danielbrownjr/JumpJet/docs/PHASE1_HARDWARE_REGISTER.md

# Phase 1 hardware source-of-truth register

Last updated: 2026-09-15

This is the living engineering register for JumpJet Rev A Phase-1 hardware
implementation. It records what is known, how it is known, what remains
provisional, and which downstream decisions are blocked. Rev A.4.1 is the
current authoritative schematic baseline and its KiCad source is checked into
the repository; the first Rev A PCB remains active Phase-1 implementation work.

> **Presence in this register does not mean BOM-final, fabrication-approved, or
> release-approved. Only the explicit status field carries authority.**

## Status legend

| Status | Meaning |
|---|---|
| CONFIRMED FACT | Supported by an authoritative project artifact or direct evidence; not merely inferred. |
| MEASURED | Directly measured, with the measurement conditions and source identified. |
| DESIGN DECISION | Deliberately selected architecture or requirement; implementation may still need validation. |
| STRONG CANDIDATE | Preferred component candidate with substantial support, but not BOM-final. |
| PROTOTYPE CANDIDATE | Part selected for characterization or prototyping only. |
| ASSUMPTION / PROVISIONAL | Working value or approach that must not be treated as final. |
| TBD / BLOCKED | Required information or selection is absent and blocks one or more downstream activities. |

Confidence describes the quality of the current evidence, not release readiness.
The **Blocks** column identifies what cannot be frozen or completed until the
remaining validation closes.

## 1. System electrical basis

| Item | Status | Current value / decision | Evidence / source | Confidence | Remaining validation | Blocks |
|---|---|---|---|---|---|---|
| System voltage | CONFIRMED FACT | 24 V system architecture. | Rev A.4.1 schematic; [CZ4060 characterization](hardware/cz4060-characterization.md) | High | Validate production-supply tolerance and transients with the complete assembly. | BOM freeze + Fabrication |
| CZ4060 conservative design basis | CONFIRMED FACT | Size the heater path for 24 V, 200 W, and 8.33 A. | Heater rating and [CZ4060 characterization](hardware/cz4060-characterization.md), commit `903e5e0cdfc7a17102d51de1c01fa414be613b92` | High | Validate every production current-path element at this design load and installed temperature. | PCB layout + BOM freeze + Fabrication |
| Standalone sustained load | MEASURED | Approximately 189 W and 7.89 A at 24 V. | 60-minute standalone run in [CZ4060 characterization](hardware/cz4060-characterization.md) | High for tested specimen and setup | Repeat or bound unit-to-unit behavior; validate installed full-path voltage drop and temperature. | BOM freeze + Fabrication |
| Standalone startup | MEASURED | Approximately 196 W peak observed; no high-current cold inrush observed. Current rose over several minutes while the bench supply remained in CV mode. | Startup test in [CZ4060 characterization](hardware/cz4060-characterization.md) | High for tested specimen and setup | Confirm behavior with the production PSU, wiring, controls, and additional heater specimens. | BOM freeze + Fabrication |
| Standalone thermal behavior | MEASURED | Heater/PTC region approximately 130 °C steady; chassis approximately 74–75 °C steady. These are characterization results, not firmware or protection thresholds. | 60-minute standalone run in [CZ4060 characterization](hardware/cz4060-characterization.md) | High for tested specimen and setup | Installed-system mapping with production airflow, sensor placement, fault cases, and materials. | Firmware constants + BOM freeze + Fabrication |
| Cold DMM resistance | MEASURED | Approximately 20–21 Ω was observed cold, but it is not authoritative for heater-path sizing. Use the powered measurements and 8.33 A conservative design basis. | Cold-resistance note in [CZ4060 characterization](hardware/cz4060-characterization.md) | High | None for current-path design basis. | None |

Firmware thresholds must not be derived directly from the standalone heater
temperatures.

## 2. ESP32-S3 Super Mini mechanical implementation

### TinyS3D candidate status

Unexpected Maker TinyS3D (Adafruit #6401) is a **PROTOTYPE CANDIDATE**.
Direct inspection and esptool confirm through-hole mounting and 8 MB flash.
The actual JumpJet Phase 0 firmware built and booted on the specimen, replacing
CircuitPython. **5 V / USB VBUS isolation/backfeed behavior remains unresolved**:
the reverse-voltage test stopped while the unloaded reading was still rising.
Loaded power-path testing, real-network provisioning and physical dimensions
remain open. Evidence, reproduction notes and the detailed checklist are in the
[TinyS3D characterization record](hardware/tinys3d-characterization.md).
Production module selection, GPIO assignment and carrier footprint remain open;
the following Super Mini evidence applies to that module only.

| Item | Status | Current value / decision | Evidence / source | Confidence | Remaining validation | Blocks |
|---|---|---|---|---|---|---|
| Module PCB body | MEASURED | 23.67 mm long × 17.91 mm wide. | Physical measurement of the actual module | High | Confirm against the 1:1 production-footprint plot before freeze. | Fabrication |
| Overall length including USB-C | MEASURED | 25.07 mm. | Physical measurement of the actual module | High | Confirm connector projection and carrier-board relationship on the 1:1 plot. | PCB layout + Fabrication |
| USB-C overhang | MEASURED | Approximately 1.40 mm beyond the module PCB edge. This is a datum, not a complete connector keepout. | Direct caliper measurement of the actual module | High for overhang only | Establish the carrier-board edge relationship, mating-plug envelope, cable-head clearance, and enclosure access. | PCB layout + Fabrication |
| USB-C shell envelope | MEASURED | Shell is 8.84 mm wide × 3.12 mm high/thick and occupies 7.48 mm over the module PCB. These shell measurements do not define the plug or enclosure keepout. | Direct caliper measurement of the actual module | High for the measured shell | Measure the mating plug and cable head; define carrier-edge and enclosure-access clearances. | PCB layout + Fabrication |
| Pad count | CONFIRMED FACT | Nine castellations per side; 18 total. | Physical inspection of the actual module | High | Verify every pad number and label against the actual module silkscreen. | PCB layout + Fabrication |
| Adjacent castellation pitch | MEASURED | 2.55 mm center-to-center. This supports, but does not replace, the provisional 2.54 mm nominal design pitch. | Direct caliper measurement of adjacent castellations on the actual module | High for the measured specimen | Verify all pad centers on the 1:1 production-footprint plot. | PCB layout + Fabrication |
| Nominal pin pitch | ASSUMPTION / PROVISIONAL | Use 2.54 mm for footprint design. Supported by the 2.55 mm adjacent measurement, ordinary 2.54 mm header fit, and a previously measured approximately 20.0 mm first-to-last center span versus the nominal 20.32 mm eight-pitch span. | Physical measurements, physical header fit, and derived nominal geometry | High | Verify all 18 pads by true-scale physical placement before freeze. | PCB layout + Fabrication |
| Nominal row spacing | ASSUMPTION / PROVISIONAL | 15.24 mm; supported by an approximately 15.2 mm physical measurement. | Physical measurement and derived nominal geometry | High | 1:1 physical placement and direct row-center verification. | PCB layout + Fabrication |
| Side edge to row center | ASSUMPTION / PROVISIONAL | Approximately 1.335 mm, derived as `(17.91 - 15.24) / 2`. | Derived from measured body width and provisional nominal row spacing | Medium | Measure actual castellation centerline relative to both module edges. | PCB layout + Fabrication |
| Castellation width | MEASURED | 1.96 mm along the module board edge. This is the module castellation width, not a frozen carrier receiving-land width. | Direct caliper measurement of the actual module | High for the measured specimen | Review solder/process margin, inward land depth, mask expansion, and paste treatment before defining the carrier land. | PCB layout + Fabrication |
| Non-USB edge to first castellation | MEASURED | 1.00 mm from the non-USB PCB edge to the near edge of the first castellation. This is explicitly not a centerline offset. | Direct caliper measurement of the actual module | High for the measured datum | Establish the footprint datum and directly verify longitudinal pad-center registration at both ends. | PCB layout + Fabrication |
| Derived longitudinal registration | ASSUMPTION / PROVISIONAL | With the footprint origin at the module-body center, +Y toward the non-USB/antenna end, and −Y toward USB, the measured 1.00 mm near-edge offset plus 1.96 mm castellation width places the non-USB end-pad center at Y = +9.855 mm. Using the nominal 20.32 mm span places the USB end-pad center at Y = −10.465 mm. | Derived from two physical measurements and the provisional nominal pitch | Medium-high for the derivation; not physically fit-verified | Verify every center against the actual module on a true-scale plot and confirm the remaining USB-end edge distance. | PCB layout + Fabrication |
| Provisional castellated footprint | ASSUMPTION / PROVISIONAL | Project-local `JumpJet:ESP32-S3_SuperMini_2x9_Castellated_PROVISIONAL` is an unassigned iteration footprint. Origin is module-body center; +Y is non-USB/antenna and −Y is USB. It uses 18 pads at X = ±7.620 mm and Y = −10.465 mm through +9.855 mm on 2.54 mm pitch. Pad size is provisionally 3.40 mm inward/outward depth × 1.80 mm along-edge width. The along-edge width leaves 0.74 mm between pads and is narrower than the measured 1.96 mm castellations; the 3.40 mm depth, mask, and paste treatment are process assumptions. | [Checked-in provisional footprint](../hardware/kicad/JumpJet_RevA/JumpJet.pretty/ESP32-S3_SuperMini_2x9_Castellated_PROVISIONAL.kicad_mod) using current measurements and derived registration | Medium | Review carrier land/process geometry, map underside contacts, verify all physical pin labels, and pass the mandatory 1:1 fit check before assigning it to U2. | Footprint freeze + PCB layout + Fabrication |
| Legacy Rev A.4.1 footprint | CONFIRMED FACT | `JumpJet:ESP32-S3_SuperMini_2x9` is a drilled 18-pad through-hole footprint. It is retained only to resolve the authoritative schematic and is explicitly obsolete for production mounting. | [Checked-in Rev A.4.1 footprint](../hardware/kicad/JumpJet_RevA/JumpJet.pretty/ESP32-S3_SuperMini_2x9.kicad_mod) | High | Do not assign it to a production PCB; replace the schematic assignment only after the provisional SMD footprint passes physical verification. | PCB layout + Fabrication |
| Ordinary header fit | MEASURED | Ordinary 2.54 mm header pins physically fit the castellation holes. This supports pitch/alignment evaluation but does not change production attachment to through-hole mounting. | Physical fit check on the actual module | High for fit observation | Measure the actual square posts and verify removable alignment-hole clearance and PCBWay drill tolerance. | PCB layout + Fabrication |
| Production mounting | DESIGN DECISION | Direct solder of the castellated module to carrier-PCB SMD lands. The current drilled through-hole footprint is not the production architecture unless later physical verification explicitly reverses this decision. | Phase-1 mounting decision; inspection of Rev A.4.1 project footprint | High | Complete and physically verify the project-local castellated footprint. | PCB layout + Fabrication |
| Mounted component side | CONFIRMED FACT | All mounted components are on the top side. The underside is physically flat apart from PCB/contact metallization. | Direct top/bottom inspection of the actual module | High | Preserve the observed orientation in the footprint and 1:1 plot. | PCB layout + Fabrication |
| Physical Pin 1 | CONFIRMED FACT | Pin 1 has been physically identified from the module photograph. | Direct photographic inspection of the actual module | High | Document the footprint datum/orientation and verify every remaining pad number and label. | PCB layout + Fabrication |
| Underside exposed contacts/test pads | CONFIRMED FACT | Exposed underside contacts/test pads are present despite there being no mounted underside components. The carrier must not place vias, exposed pads, or other exposed conductive features where unintended contact is possible; even soldermask-covered copper requires spacing/stackup review. | Direct underside inspection of the actual module | High for presence; envelope not mapped | Measure and map the exact contact locations/envelope before fabrication and verify the isolation region in the footprint/PCB. | Footprint freeze + PCB layout + Fabrication |
| Solid carrier beneath module | DESIGN DECISION | Use solid carrier PCB beneath the module. No underside components require height clearance, and no independent manufacturing or mechanical need for a cutout was found. Keep the region isolation-controlled and soldermask-covered, with no exposed copper or vias where module contacts could touch. The opening is not a safety airflow feature. | Direct inspection: no underside components; exposed contacts are present | High for architecture; contact map still incomplete | Map the underside contacts; review mask registration, dielectric/isolation margin, cleaning, and routing before fabrication. | Footprint freeze + PCB layout + Fabrication |
| Central PCB window | DESIGN DECISION | Do not create a central window on current evidence. Reopen only if a concrete cleaning, inspection, thermal, assembly, or mechanical requirement is demonstrated. | Solid-carrier architecture review | High | None unless new evidence independently justifies a window. | None |
| Optional temporary locating holes | ASSUMPTION / PROVISIONAL | Assembly concept only: two holes total at the ends of one castellated row may accept removable ordinary 2.54 mm male-header pins for alignment/tack soldering. The header is removed afterward; production attachment remains the castellated solder joints. | Phase-1 assembly concept and physical header-fit observation | Medium | Verify post dimensions, insertion/removal clearance, PCBWay drill capability/tolerance, land support, antenna/USB clearance, and that the module is not forced into alignment. | PCB layout + Fabrication |
| Locating-hole geometry | ASSUMPTION / PROVISIONAL | Candidate holes remain Ø1.10 mm NPTH. The old X = −7.620 mm, Y = ±12.700 mm pair does not form one-pitch extensions of the newly derived asymmetric end-pad centers under the documented body-center/+Y-antenna datum, so it is not implemented in the provisional footprint. | Updated longitudinal-registration audit of the earlier assembly-aid proposal | High confidence that the old coordinates are unreconciled | Measure the actual header; derive new candidate coordinates from verified pad centers; verify PCBWay finished-hole/position tolerances; physically fit-test insertion/removal and check USB/antenna/land interference. | PCB layout + Fabrication |
| Likely onboard antenna | ASSUMPTION / PROVISIONAL | The small red/white ceramic component at the non-USB end is treated as the likely onboard 2.4 GHz antenna unless inspection or revision-matched evidence disproves it. Do not assume WROOM-class RF performance. | Direct top-side inspection and component appearance | Medium | Confirm function/location and establish the antenna datum and installed orientation. | PCB layout + Fabrication |
| Antenna keepout | ASSUMPTION / PROVISIONAL | Prefer the antenna at a carrier-board edge. The provisional footprint graphically reserves the interior area X = ±6.50 mm, Y = +7.835 to +11.835 mm at the likely antenna end as a visible no-copper warning. This is not an enforced KiCad rule area and is not exact RF geometry. No heater-current or buck switch-node copper, fuse hardware, planes, vias, traces, or large metal may be placed there or immediately beyond the antenna end until the keepout is verified. | Likely antenna location plus conservative footprint iteration | Medium-low for exact bounds | Confirm the antenna and feed geometry, replace the graphic with an enforced all-applicable-layer rule, define enclosure clearance, and validate installed Wi-Fi RSSI/range. | PCB layout + Fabrication |
| USB-C mechanical keepout | TBD / BLOCKED | The shell is measured, but the mating-plug envelope, cable-head clearance, enclosure opening, and carrier-board edge relationship remain undefined. Do not derive the complete keepout from shell dimensions alone. | Direct shell measurements; service-access geometry incomplete | High confidence that evidence remains incomplete | Complete plug, cable-head, carrier-edge, and enclosure-access measurements. | PCB layout + Fabrication |
| Mandatory 1:1 verification | DESIGN DECISION | The actual module must be placed on a true-scale plot before footprint freeze. All 18 castellations, body, Pin 1/orientation, optional locating holes, USB projection, antenna direction/keepout, and underside isolation region must pass without forced alignment. | Phase-1 acceptance requirement | High | Perform and document the physical fit check using the final proposed footprint. | Fabrication |

## 3. ESP32 power architecture

| Item | Status | Current value / decision | Evidence / source | Confidence | Remaining validation | Blocks |
|---|---|---|---|---|---|---|
| Production power domains | DESIGN DECISION | One shared 24 V-derived 5 V regulator feeds `+5V_SYS_GATE`. The heater gate driver remains directly on that actuator rail, while the MCU branch passes through D4 reverse isolation, `+5V_MCU_FEED`, and physical SW1 before reaching the Super Mini `+5V_MCU`/USB-VBUS tied node. USB is never routed to `+5V_SYS_GATE`; USB-only power must be physically incapable of energizing that rail or any actuator domain. | Phase-1 power-domain and service-safety decision; implemented D4/SW1 source path; measured module 5 V topology | High | Qualify the regulator, isolation element, disconnect, and full normal/service/misuse transition matrix. | PCB layout + BOM freeze + Fabrication |
| USB-C role | DESIGN DECISION | Programming, debug, recovery, and service only; not the normal installed power source. Board-derived MCU 5 V must be physically disconnected before attaching a powered USB host. USB may power only the Super Mini-side MCU logic node and must not energize `+5V_SYS_GATE`, the gate driver, or Q1 actuation. | Phase-1 service architecture and measured bidirectional VBUS/5 V coupling | High | Validate every USB-only and mixed-presence power state and observe both 5 V sides, gate rail, OE, PWM input, and Q1 gate during attach/remove. | PCB layout + Fabrication |
| External 5 V/VBUS pin | MEASURED | USB VBUS and the Super Mini exposed 5 V pin are effectively the same node for system design. With 4.993 V applied at the exposed pin, USB VBUS measured 4.992 V. With USB supplied at 5.13 V, the exposed pin measured 5.11 V. Unpowered continuity was confirmed and diode-mode behavior was consistent with direct coupling. | Direct bench characterization of the actual ESP32-S3 Super Mini | High for the tested module | Preserve the measured topology in the schematic and validate production-module consistency during receiving/bring-up. | None |
| USB/external-5 V relationship | CONFIRMED FACT | The Super Mini provides no usable isolation between USB VBUS and its exposed 5 V pin. USB powers the exposed pin, and external 5 V on that pin energizes the USB connector VBUS. Simultaneous board-derived 5 V and a powered USB host must be treated as unsafe unless one source is physically isolated before the tied module node. | Bidirectional voltage and unpowered continuity measurements on the actual module | High | Do not perform simultaneous-source testing with the disconnect closed. Verify the completed carrier implements the required isolation boundary. | PCB layout + Fabrication |
| MCU branch reverse isolation | DESIGN DECISION | The MCU branch shall conduct only `+5V_SYS_GATE -> D4 -> +5V_MCU_FEED`; reverse current from USB/`+5V_MCU` toward `+5V_SYS_GATE` is forbidden. This hardware invariant protects the actuator rail during valid USB service and misuse states without firmware. | Implemented D4/SW1 Phase-1 schematic source path and measured bidirectional Super Mini VBUS/5 V coupling | High for topology | Qualify reverse leakage, forward drop, dissipation, temperature, and USB/24 V transitions on production-intent hardware. | PCB layout + BOM freeze + Fabrication |
| MCU isolation element | STRONG CANDIDATE | D4 is a low-Vf Schottky class with at least 2 A practical current capability, low drop around 0.5–1.0 A, low elevated-temperature reverse leakage, at least 20 V VRRM, and a package comfortable in the approximately 0.2–0.4 W dissipation class. Exact MPN and footprint are TBD and it is not BOM-final. | Phase-1 isolation architecture and provisional MCU load/dissipation envelope | Medium | Measure MCU peak current; select the exact diode/package; calculate and measure hot drop, loss, leakage, and temperature; review availability. | PCB layout + BOM freeze + Fabrication |
| Physical MCU service-power disconnect | DESIGN DECISION | Rev A places firmware-independent SW1 in series between `+5V_MCU_FEED` and the Super Mini-side `+5V_MCU`/USB-VBUS tied node. RUN closes board-derived MCU power; USB SERVICE opens it before host attachment. A solder bridge is not acceptable, and a removable jumper is not primary production intent unless the switch proves mechanically impractical. | Measured module topology, explicit Rev A service policy, and implemented D4/SW1 schematic path | High for architecture | Select and rate the switch after measuring MCU-path current; verify footprint, voltage drop, accessibility near USB, connector clearance, labeling, retention, and misuse visibility. | PCB layout + BOM freeze + Fabrication |
| Disconnect implementation | STRONG CANDIDATE | SW1 is a positive-detent SPST slide-switch class rated at least 2 A at 5 V DC, with contact resistance targeted at no more than 50 mΩ and an absolute design ceiling of 100 mΩ; at least 85 °C operation is preferred. Exact MPN and footprint remain TBD and it is not BOM-final. | Rev A simplicity, auditability, service requirements, and implemented generic SW1 symbol | Medium-high | Measure module current including boot/Wi-Fi bursts; select a rated part and footprint; prove electrical loss, temperature, retention, access, and clearance in the aligned model and 1:1 mockup. | PCB layout + BOM freeze + Fabrication |
| MCU service labeling | DESIGN DECISION | Later PCB silkscreen shall label SW1 states `RUN` and `USB SERVICE` and instruct the technician to set USB SERVICE before connecting powered USB. Exact shortened wording, placement, and orientation remain unresolved until the service geometry is known. | Rev A mutually exclusive service-power policy | High for requirement; implementation unresolved | Verify the final instruction is visible through the service-access path, cannot be mistaken for an actuator control, and remains legible after assembly. | PCB layout + Fabrication |
| Prohibited simultaneous-source state | DESIGN DECISION | `24 V present + powered USB connected + SW1 in RUN` is a prohibited service configuration because the tied module node can create source contention. The D4 reverse boundary must nevertheless prevent USB/`+5V_MCU` from back-powering `+5V_SYS_GATE`; no supported coexistence is claimed. | Measured module topology, D4/SW1 architecture, and explicit misuse policy | High | Label clearly and verify the heater-domain isolation invariant without intentionally sustaining source contention. | PCB layout + Fabrication |
| TPS2116-only source-mux direction | CONFIRMED FACT | Superseded and not sufficient as a USB/external-5 V coexistence solution. A carrier-side TPS2116 cannot independently select USB VBUS versus the exposed module 5 V pin because those nodes are already directly coupled on the Super Mini. TPS2116 is not required by the adopted Rev A mutually exclusive service-power architecture. | Measured module topology compared with [TI TPS2116 product behavior](https://www.ti.com/product/TPS2116) | High | Reconsider only for a narrower future requirement with genuinely separate source nodes; do not place it for Rev A without such a requirement. | None |
| Buck converter candidate | STRONG CANDIDATE | TI LMR36520 synchronous buck: published 4.2–65 V input, 2 A output, up to 70 V input transients, −40 to +125 °C operating junction range, power-good option, and approximately 90% published efficiency at 24 V input, 5 V output, and 1 A. The present `MOD1` connector symbol is only an architecture placeholder, not a discrete implementation or BOM-final part. | [TI LMR36520 product page](https://www.ti.com/product/LMR36520) and Phase-1 regulator review | High for published characteristics; medium for product fit | Select exact ordering code and switching frequency; implement and review the complete discrete circuit, magnetics, compensation/support parts, layout, efficiency/dissipation, transient behavior, and installed-temperature derating. | PCB layout + BOM freeze + Fabrication |
| Buck converter capacity target | ASSUMPTION / PROVISIONAL | Use at least 1.5 A continuous capability as an initial converter target. This is not a selected MPN or BOM-final rating. | Preliminary ESP32-S3 peak/burst allowance plus light interface-load margin | Medium | Complete the 5 V load inventory and converter loss/thermal derating at the maximum installed chamber/PCB temperature; increase the rating if required. | PCB layout + BOM freeze + Fabrication |
| Power-management firmware assumptions | TBD / BLOCKED | Firmware may rely on the architectural fact that USB cannot power the actuator rail, but may not assume the physical disconnect position, board-5-V availability, power-good behavior, or heater availability without truthful hardware evidence. When 24 V is removed while USB remains, MCU logic may stay alive but heater actuation must be reported unavailable. | Adopted Rev A power-domain architecture; disconnect sensing and power-good implementation unresolved | High | Close the implemented power-state truth table and determine whether disconnect position and board/gate-rail availability are observable. | Firmware constants |

### Rev A power-state truth table

| 24 V | USB | SW1 | Expected state |
|---|---|---|---|
| OFF | OFF | RUN | `+5V_SYS_GATE` OFF; MCU OFF. |
| ON | OFF | RUN | `+5V_SYS_GATE` ON; MCU ON; normal operation. |
| ON | OFF | USB SERVICE | `+5V_SYS_GATE` ON; MCU OFF; heater driver remains hardware-disabled without MCU enable. |
| OFF | ON | USB SERVICE | `+5V_SYS_GATE` OFF; MCU ON; valid USB service. |
| OFF | ON | RUN | `+5V_SYS_GATE` must remain OFF; MCU ON; misuse state with heater domain isolated. |
| ON | ON | USB SERVICE | `+5V_SYS_GATE` ON; MCU is USB-powered; valid service state; heater driver remains default-disabled. |
| ON | ON | RUN | Prohibited source-contention state; no supported coexistence claim; D4 must still block USB backfeed into `+5V_SYS_GATE`. |

When 24 V disappears, `+5V_SYS_GATE` collapses, U1 loses VCC, its active-low OE defaults disabled, and the direct Q1 pulldown discharges the gate. If USB remains, `+5V_MCU` may remain alive while D4 keeps `+5V_SYS_GATE` dead; U1's candidate `Ioff` behavior must be qualified to prevent MCU inputs from parasitically powering the unpowered gate-driver domain.

### Provisional 5 V load inventory

| Load | Status | Current value / decision | Evidence / source | Confidence | Remaining validation | Blocks |
|---|---|---|---|---|---|---|
| ESP32-S3 Super Mini | ASSUMPTION / PROVISIONAL | Allocate approximately 600 mA for module peak/Wi-Fi/boot demand; this is a design allocation, not a measured revision-specific maximum. | Phase-1 provisional load budget; exact module power topology and revision remain unverified | Medium | Measure boot and radio bursts on the actual module across supported operating conditions. | BOM freeze + Fabrication |
| Gate buffer and Q1 gate charging | ASSUMPTION / PROVISIONAL | Allocate less than 20 mA for gate logic and gate charging. Gate drive belongs only to `+5V_SYS_GATE`; actual dynamic current depends on the still-unfrozen PWM frequency and Q1 waveform. | SN74LV4T125/CSD18540Q5B candidate architecture and provisional load budget | Medium-low | Qualify the driver/passives; freeze PWM only after waveform/loss review; measure rail transients and average/peak current. | BOM freeze + Firmware constants + Fabrication |
| Fan PWM/tach interface | TBD / BLOCKED | Include open-drain PWM, tach pull-up/interface, and any protection/filter loads; fan motor power remains on fused 24 V. | Four-wire interface architecture; candidate-specific electrical details pending | High confidence that a numeric load is missing | Complete delivered-fan datasheet/bench characterization and select interface values. | BOM freeze + Fabrication |
| Sensor/reference support | TBD / BLOCKED | Include every actual 3.3 V/5 V thermistor, reference, ADC-filter, and level-interface load after the sensing implementation is finalized. | Rev A.4.1 sensing architecture is not a frozen load inventory | High confidence that a numeric load is missing | Reconcile final sensing schematic and regulator/LDO efficiencies. | BOM freeze + Fabrication |
| Qwiic and service expansion | ASSUMPTION / PROVISIONAL | Allocate up to 250 mA if retained; this is a bounded design allowance, not measured consumption or permission for an unbounded external load. | Rev A.4.1 Qwiic/service provisions and Phase-1 provisional load budget | Medium | Decide retained interfaces and enforce the maximum external current; protect and measure simultaneous worst case. | BOM freeze + Fabrication |
| LED and miscellaneous board logic | ASSUMPTION / PROVISIONAL | Allocate approximately 30 mA. | Preliminary Phase-1 load inventory | Low-medium | Reconcile the final schematic and measure actual simultaneous load. | BOM freeze + Fabrication |
| Other explicit margin allocation | ASSUMPTION / PROVISIONAL | Allocate approximately 50 mA before the final engineering margin. | Preliminary Phase-1 load inventory | Low-medium | Replace with itemized loads as the schematic closes. | BOM freeze + Fabrication |
| Working total and converter headroom | ASSUMPTION / PROVISIONAL | Working allocation is approximately 950 mA before engineering margin. Adding 25–30% gives approximately 1.2–1.25 A, so at least 1.5 A continuous capability remains the provisional floor; the 2 A LMR36520 is the preferred strong candidate. | Sum of provisional allocations above | Medium-low until loads are measured | Sum measured simultaneous peaks and verify converter efficiency, transient response, and temperature at maximum installed ambient. | PCB layout + BOM freeze + Fabrication |

## 4. Heater path and independent interruption

| Item | Status | Current value / decision | Evidence / source | Confidence | Remaining validation | Blocks |
|---|---|---|---|---|---|---|
| Rev A.4.1 heater path | CONFIRMED FACT | `+24V_PROT -> F2 -> TF1 -> TS1 -> J2 -> external heater -> Q1 -> GND` | Current Rev A.4.1 schematic | High | Recheck connectivity after every schematic revision and against the first PCB. | PCB layout + Fabrication |
| Independent series protection | CONFIRMED FACT | TF1 and TS1 are physically in series with heater current; firmware is not the sole means of heater interruption. | Current Rev A.4.1 schematic | High for topology | Select and validate final parts, mounting, temperatures, current capacity, and installed fault behavior. | PCB layout + BOM freeze + Firmware constants + Fabrication |
| Complete heater-current path | TBD / BLOCKED | The assembled path has not been validated for voltage drop, heating, or fault interruption. | [CZ4060 characterization](hardware/cz4060-characterization.md) explicitly excludes Q1, F2, PCB copper, connectors, wiring, and installed behavior | High confidence that validation is incomplete | Validate final parts, PCB geometry, full-path voltage drop, component/copper temperatures, and installed fault cases. | BOM freeze + Fabrication |

## 5. Q1 heater MOSFET and gate drive

| Item | Status | Current value / decision | Evidence / source | Confidence | Remaining validation | Blocks |
|---|---|---|---|---|---|---|
| Q1 candidate | STRONG CANDIDATE | Texas Instruments CSD18540Q5B; 60 V logic-level N-MOSFET; maximum `RDS(on)` approximately 3.3 mΩ at 4.5 V. Not BOM-final. | Manufacturer data and Phase-1 component review | High for published characteristics | Reconfirm ordering code, lifecycle, package, pin/multipad mapping, and production availability. | PCB layout + BOM freeze + Fabrication |
| Estimated Q1 conduction loss | ASSUMPTION / PROVISIONAL | About 0.205 W at 7.89 A and 0.229 W at 8.33 A using 3.3 mΩ: `P = I²R`. These are max-`RDS(on)`-basis conduction estimates only, not total hot operating loss. | Candidate data and measured/design currents | Medium | Include hot `RDS(on)`, switching loss, duty/frequency, gate waveform, copper spreading, and measured junction/board temperature. | PCB layout + BOM freeze + Firmware constants + Fabrication |
| Rev A.4.1 gate-buffer defect | CONFIRMED FACT | The authoritative Rev A.4.1 baseline used SN74AHCT125 buffering with the used active-low OE inputs tied low, so enable was not hardware-default-disabled. The Phase-1 power sheet now supersedes that implementation while preserving this row as baseline evidence. | [Checked-in Phase-1 power/output sheet](../hardware/kicad/JumpJet_RevA/JumpJet_Power_Outputs.kicad_sch); [TI SN74AHCT125 product page](https://www.ti.com/product/SN74AHCT125) | High | Preserve provenance and verify the replacement behavior natively and on the bench. | Fabrication |
| Gate-buffer candidate | STRONG CANDIDATE | SN74LV4T125 in TSSOP-14 is the production-intent candidate. TI publishes 1.8–5.5 V operation, 5.5 V-tolerant inputs, translation support, active-low OE, −40 to +125 °C operation, and `Ioff` partial-power-down support. It is powered only by `+5V_SYS_GATE`; it is not BOM-final. | [TI SN74LV4T125 product page](https://www.ti.com/product/SN74LV4T125) and implemented Phase-1 schematic | High for published characteristics; medium for final selection | Verify exact ordering code, pin mapping/library symbol, input thresholds at 3.3 V, leakage, timing, output drive, gate waveform, and installed-temperature behavior. | PCB layout + BOM freeze + Fabrication |
| Default-disabled OE architecture | DESIGN DECISION | `R20` provisionally pulls heater-channel `/OE` to `+5V_SYS_GATE`. `Q4` (`Q_GATE_EN`, provisional 2N7002-class device) can pull `/OE` low only when generic unassigned net `HEATER_GATE_EN` is asserted. Its gate has a direct pull-down. MCU reset/high-Z/unpowered/disconnected therefore leaves the driver disabled. Unused buffer channels are held disabled, and USB-only power cannot energize the gate-driver rail. | Implemented Phase-1 power/output schematic and TI active-low OE/Ioff behavior | High for intended topology | Run the mandatory 24 V/USB/reset/brownout/attach/remove transition matrix while observing both rails, OE, PWM input, Q1 gate, and source reference. Verify Q4 leakage and resistor values at temperature. | PCB layout + BOM freeze + Fabrication |
| Heater PWM command path | DESIGN DECISION | Generic unassigned `HEATER_PWM_CMD` feeds the U1 A input with a direct input pull-down; no MCU pin is assigned. U1 `Ioff` is intended to prevent back-power through this input while its VCC is absent. U1 Y drives `HTR_GATE` through the provisional series resistor. | Implemented Phase-1 power/output schematic | High for topology | Verify unpowered leakage, logic levels, transitions, and gate waveform on representative hardware. | PCB layout + BOM freeze + Firmware constants + Fabrication |
| Gate network values | ASSUMPTION / PROVISIONAL | `R1` is 47 Ω provisional; the direct Q1 gate pull-down `R2` is 10 kΩ provisional; the PWM-input pull-down remains 100 kΩ provisional. The stronger Q1 pull-down improves deterministic turnoff while dissipating only milliwatts when driven high. | CSD18540Q5B maximum gate charge is approximately 26 nC at 4.5 V; Phase-1 leakage/turnoff review | Medium | Select final resistance from leakage, turn-off, gate waveform, PWM frequency, switching loss, and driver-current validation. | PCB layout + BOM freeze + Firmware constants + Fabrication |
| Gate/power test points | DESIGN DECISION | `TP11`–`TP17` expose `+5V_SYS_GATE`, the Super Mini-side `+5V_MCU`/USB-VBUS tied node, heater `/OE`, `HEATER_PWM_CMD`, Q1 gate, Q1 source reference, and pre-switch `+5V_MCU_FEED`. TP17 is a bounded bring-up point for verifying D4 and SW1 isolation. | Implemented Phase-1 power/output schematic plus measured module topology | High for schematic provision | Verify footprint accessibility and use both sides of the disconnect plus all gate points in the power-transition bench matrix. | PCB layout + Fabrication |
| Q1 footprint and thermal implementation | TBD / BLOCKED | Exact verified KiCad footprint, thermal-pad implementation, and copper spreading are not frozen. | Footprint/PCB validation not completed | High confidence that implementation is incomplete | Verify package drawing and pad mapping; complete thermal/current layout and measurement plan. | PCB layout + Fabrication |
| Rev A.4.1 Q1 mapping defect | CONFIRMED FACT | Q1 currently uses a generic `Q_NMOS_GDS` symbol and unresolved `Package_DirectFET:TBD` footprint. CSD18540Q5B is published as an 8-pin 5 mm × 6 mm VSON-CLIP (DNK), so the current footprint assignment cannot represent the candidate package or multipad mapping. | [Rev A.4.1 power/output sheet](../hardware/kicad/JumpJet_RevA/JumpJet_Power_Outputs.kicad_sch); [TI CSD18540Q5B product/datasheet page](https://www.ti.com/product/CSD18540Q5B) | High | Build/verify the exact DNK symbol-to-pad mapping, exposed/current pads, land pattern, solder treatment, and thermal copper against the manufacturer drawing. | PCB layout + BOM freeze + Fabrication |

## 6. F2 fuse and holder

| Item | Status | Current value / decision | Evidence / source | Confidence | Remaining validation | Blocks |
|---|---|---|---|---|---|---|
| F2 fuse candidate | STRONG CANDIDATE | Littelfuse 0287015.U, 15 A ATOF. Not BOM-final. The 15 A candidate provides healthier margin around the approximately 7.9–8.33 A load than a 10 A fuse after elevated-temperature derating. | Heater characterization, conservative design basis, and Phase-1 component review | Medium-high | Validate production-PSU short-circuit/current-limit behavior, time-current coordination, ambient derating, interrupt behavior, and service conditions. | PCB layout + BOM freeze + Fabrication |
| F2 holder candidate | STRONG CANDIDATE | Littelfuse 178.6165.0001, published as a four-terminal PCB-mount ATO holder. Not BOM-final. Rev A.4.1 has no F2 footprint assigned. | [Littelfuse 178.6165.0001 product page](https://www.littelfuse.com/products/fuses-overcurrent-protection/fuse-holders-fuse-blocks-accessories/fuse-holders/in-line-fuse-holders/ato-flr/178-6165-0001); checked-in schematic | Medium-high | Verify manufacturer drawing, four-hole/pad mapping, voltage/current and chamber-temperature performance, pad/copper heating, retention, and fuse removal/service clearance. | PCB layout + BOM freeze + Fabrication |

## 7. J2 and heater wiring

| Item | Status | Current value / decision | Evidence / source | Confidence | Remaining validation | Blocks |
|---|---|---|---|---|---|---|
| J2 candidate | STRONG CANDIDATE | Phoenix Contact 1715022 / MKDS 1,5/2; nominal IEC current approximately 17.5 A and 5.00 mm pitch. Rev A.4.1 assigns KiCad footprint `TerminalBlock_Phoenix_MKDS-1,5-2_1x02_P5.00mm_Horizontal`. The 8.33 A heater basis is approximately 48% of the nominal current. Not BOM-final. | [Phoenix Contact 1715022 catalog](https://www.phoenixcontact.com/us/products/1715022); checked-in schematic | Medium-high | Compare the KiCad land pattern to the current manufacturer drawing; verify conductor/ferrule compatibility, torque, non-thermal-relief current entry, terminal/pad temperature, and service access. | PCB layout + BOM freeze + Fabrication |
| Heater wire | DESIGN DECISION | Use 16 AWG high-temperature-insulated wire, with approximately 200 °C-class insulation near the heater. | Current requirement and heater thermal environment | High for direction | Finalize insulation construction, color, length, routing, bend radius, abrasion protection, and installed-temperature margin. | BOM freeze + Fabrication |
| Wire family | STRONG CANDIDATE | TE Connectivity/Raychem Spec 55 family; examples 55/0212-16-2 red and 55/0212-16-0 black. Not BOM-final. | Phase-1 wiring review | Medium | Verify exact construction, approvals, availability, termination method, voltage drop, and harness temperature. | BOM freeze |
| Heater termination details | TBD / BLOCKED | Ferrule type, terminal torque, strain relief, wire length, voltage drop, and terminal/harness temperatures are not frozen. | Harness and installed validation incomplete | High confidence that details are incomplete | Build and thermally validate the production-intent harness and termination. | BOM freeze + Fabrication |
| JST-XH heater use | DESIGN DECISION | JST-XH is not acceptable for the approximately 8 A heater-current path. | Current-path requirement | High | None; maintain this exclusion through schematic and PCB review. | None |

## 8. Fan architecture and prototype

| Item | Status | Current value / decision | Evidence / source | Confidence | Remaining validation | Blocks |
|---|---|---|---|---|---|---|
| Original integrated fan | CONFIRMED FACT | YD4020HBL, 24 V, 0.13 A, two-wire, no native PWM, and no tach. Its two-wire control architecture has been superseded by the four-wire PWM/tach direction. | Physical/product identification from CZ4060 assembly review | Medium-high | Confirm nameplate and electrical behavior if retained for comparative testing only. | None |
| Rev A.4.1 two-wire fan block | CONFIRMED FACT | The Rev A.4.1 baseline originally used F3/J3/D2/Q2/R3/R4 as a fused two-wire low-side-switched fan-power block. Phase-1 source removes D2, repurposes Q2/R3/R4 for the low-current PWM interface, and replaces J3 with the reviewed provisional four-wire interface. The old switched-power architecture remains baseline evidence only and is obsolete for production. | [Phase-1 power/output sheet](../hardware/kicad/JumpJet_RevA/JumpJet_Power_Outputs.kicad_sch) and checked-in Rev A.4.1 provenance | High | Run native KiCad open/ERC and review the provisional interface against the delivered fan and final connector. | PCB layout + BOM freeze + Fabrication |
| Replacement fan prototype | PROTOTYPE CANDIDATE | Sanyo Denki 9GA0424P3J001; ordered for characterization, ETA 2026-09-15. Not BOM-final. | Prototype purchase record and [characterization record](hardware/9ga0424p3j001-characterization.md) | High for order state; unvalidated for application | Complete electrical, airflow, pressure, acoustic, thermal, stall, and installed-system characterization. | BOM freeze + Firmware constants |
| Published prototype electrical data | CONFIRMED FACT | Model-specific manufacturer data states 24 V rated, 21.6–26.4 V operating range, 0.27 A, 6.48 W, pulse sensor, and PWM control. These facts apply only to 9GA0424P3J001. | [Manufacturer product page](https://products.sanyodenki.com/en/sanace/dc/dc-fan/9GA0424P3J001/) summarized in the [characterization record](hardware/9ga0424p3j001-characterization.md) | High | Verify delivered-specimen identity and behavior; do not generalize to a production substitute. | BOM freeze + Firmware constants |
| Prototype lead convention | ASSUMPTION / PROVISIONAL | Manufacturer installation material gives the general San Ace convention of red positive, black/blue ground, yellow sensor, and brown PWM. Treat the ordered model provisionally as four AWG26 leads with red +24 V, black GND, yellow tach, and brown PWM until the delivered specimen or model drawing verifies gauge and functions. | San Ace manual `M0011876C`; Sara 30 handoff; [characterization record](hardware/9ga0424p3j001-characterization.md) | Medium | Inspect the delivered label/leads and verify electrically before applying power. | BOM freeze + Fabrication |
| Four-wire fan architecture | DESIGN DECISION | `+24V_PROT -> F3 -> FAN_24V -> J3 pin 1`, continuous GND on pin 2, separate tach on pin 3, and separate open-drain PWM on pin 4. Do not low-side PWM fan supply. F3 remains dedicated branch protection with rating TBD. | Phase-1 fan architecture decision and [Phase-1 power/output sheet](../hardware/kicad/JumpJet_RevA/JumpJet_Power_Outputs.kicad_sch) | High for topology | Qualify branch protection, final connector/fan, interface values, and installed behavior. | PCB layout + BOM freeze + Fabrication |
| J3 connector | STRONG CANDIDATE | Four-position JST-XH, logical pinout 1 FAN_24V, 2 GND, 3 FAN_TACH, 4 FAN_PWM. The schematic uses the vertical B4B-XH-A footprint provisionally; vertical versus right-angle mating direction is not frozen. Not BOM-final. | Phase-1 schematic implementation | Medium | Verify final fan termination, mating housing/contact current, polarity, keying, harness strain relief, installed orientation, and service clearance. | PCB layout + BOM freeze + Fabrication |
| Fan PWM interface | DESIGN DECISION | Use an open-drain N-MOSF stage with a direct gate pulldown. MCU unpowered/reset leaves the transistor off and the fan control lead open. Do not add an external PWM pull-up without model-specific justification. `MCU_FAN_PWM` remains unassigned to a controller pin. `TP_FAN_PWM` is provided. | Manufacturer PWM technical material and [Phase-1 power/output sheet](../hardware/kicad/JumpJet_RevA/JumpJet_Power_Outputs.kicad_sch) | High for topology; behavior not yet model-qualified | Verify model-specific control levels/frequency, high-Z and 0% behavior, startup behavior, and failure polarity on the delivered specimen. | BOM freeze + Firmware constants + Fabrication |
| Fan PWM components | ASSUMPTION / PROVISIONAL | Q2 is repurposed as a 2N7002-class SOT-23 control transistor; R3 is a provisional 1 kΩ gate series resistor and R4 a 100 kΩ direct gate pulldown. Exact MPN and values are not BOM-final. | Phase-1 schematic implementation | Medium | Select the transistor and values from control-input limits, leakage, waveform, EMI, and temperature validation. | PCB layout + BOM freeze + Fabrication |
| Prototype PWM behavior | ASSUMPTION / PROVISIONAL | Test 25 kHz as a candidate point. Open-control/full-speed behavior and 0%-command/stop behavior are expected but not frozen: available manufacturer technical material says frequency and response differ by model. | Sara 30 handoff; manufacturer PWM technical material; [characterization record](hardware/9ga0424p3j001-characterization.md) | Medium-low until model-specific evidence or bench data exists | Obtain the model drawing/specification or verify high-Z, 0%, and frequency behavior on the delivered specimen. | BOM freeze + Firmware constants + Fabrication |
| Fan tach interface | ASSUMPTION / PROVISIONAL | J3 tach feeds a provisional 1 kΩ series resistor, 10 kΩ pull-up to 3.3 V, DNP filter capacitor provision, generic `FAN_TACH` controller-side net, and `TP_FAN_TACH`. Do not pull tach to 5 V or 24 V. The open-collector interpretation remains provisional. | Phase-1 schematic implementation and general San Ace pulse-sensor material | Medium | Verify exact output circuit, voltage/current limits, pull-up, protection/filter need, pulses/revolution, waveform, and stall semantics. | PCB layout + BOM freeze + Firmware constants + Fabrication |
| Fan performance envelope | TBD / BLOCKED | Startup/steady current, minimum reliable PWM/speed, RPM versus duty, CZ4060 airflow/static pressure, locked-rotor behavior, stall-detection latency, hub temperature, installed chamber margin, cooldown versus RPM, and minimum safe airflow/RPM remain unknown. | Prototype characterization pending | High confidence that evidence is missing | Complete bench and installed-system characterization. Do not freeze RPM thresholds beforehand. | BOM freeze + Firmware constants |
| Fan branch fuse | TBD / BLOCKED | F3 remains dedicated protection for the continuous 24 V fan branch; no production rating or footprint is selected. | Phase-1 schematic architecture | High confidence selection is open | Measure startup/locked-rotor behavior and coordinate fuse rating/time-current behavior with wiring, connector, fan, and production PSU. | PCB layout + BOM freeze + Fabrication |

The first PCB may include configurable interface provisions, but fabrication is
acceptable only if the unresolved interface is deliberately bounded and does not
require unsupported electrical assumptions.

### Rev A thermal sensing contract

| Item | Status | Current value / decision | Evidence / source | Confidence | Remaining validation | Blocks |
|---|---|---|---|---|---|---|
| Four-channel Rev A sensing | DESIGN DECISION | Rev A retains the three remote channels `T_CHAMBER`, `T_OUTLET`, and `T_CASE_EXTERNAL` and adds `T_PCB` as a fourth, onboard SMD NTC channel. No existing thermal channel is removed. | Finalized Phase-1 thermal-channel steering and checked-in thermistor sheet | High for channel semantics | Verify all four channels together on production-intent hardware. | Firmware constants + PCB layout + Fabrication |
| `T_PCB` role | DESIGN DECISION | `T_PCB` monitors local electronics/PCB heat soak, including correlation with buck/regulator, MOSFET, fuse/terminal, enclosure, and `T_CASE_EXTERNAL` behavior. It is not chamber temperature and is not equivalent to `T_CASE_EXTERNAL`. | Finalized Phase-1 thermal-channel steering | High | Compare all four channels during normal heating, heat soak, cooldown, airflow-fault-oriented tests, high ambient, and power-section stress. Rev B may remove `T_CASE_EXTERNAL` only if validation shows `T_PCB` is equal or better for the intended safety-relevant role. | Firmware constants + PCB layout + Fabrication |
| `T_PCB` front end | DESIGN DECISION | `TH1` is a provisioned onboard 10 kΩ SMD NTC using the existing 3.3 V, 10 kΩ 0.1% pull-up, 1 kΩ ADC-series, and 100 nF filter philosophy (`R16`, `R17`, `C8`). The unassigned product-local ADC net is `TEMP_PCB_ADC`. `TH1` retains the legacy connector-shaped graphic as a bounded representation blocker until it can be replaced natively without corrupting the archived mixed-schema hierarchy. | Checked-in thermistor sheet; topology matched to the three existing channels | High for electrical topology; symbol and component selection unresolved | Replace the placeholder graphic with a native thermistor symbol, then validate ADC range, noise, open/short detectability, return-path integrity, and conversion calibration. | Firmware constants + PCB layout + BOM freeze + Fabrication |
| `T_PCB` device and firmware constants | TBD / BLOCKED | Exact NTC MPN, Beta, tolerance, temperature rating, ADC/GPIO assignment, conversion constants, and firmware thresholds are not selected. No thermal thresholds are implied by this channel addition. | Required evidence is not yet available | High confidence that selection remains open | Select and qualify the NTC; assign ADC only with the complete controller pin plan; derive constants and thresholds from measured hardware. | Firmware constants + BOM freeze + Fabrication |
| `T_PCB` placement | TBD / BLOCKED | Exact placement remains open. Sense representative local electronics/PCB temperature, not a component junction or fan inlet. Do not place directly against Q1 thermal copper, buck switch-node copper, under the ESP32-S3, in the fan cold-air jet, against the heater connector or fuse-holder copper, or on a pour dominated by one hot component. | Layout has not begun; no `.kicad_pcb` exists | High confidence that placement remains open | Establish placement after the PCB plane, component placement, airflow, and high-current geometry are known; validate correlation against `T_CASE_EXTERNAL`. | PCB layout + Fabrication |

## 9. Independent thermal protection

| Item | Status | Current value / decision | Evidence / source | Confidence | Remaining validation | Blocks |
|---|---|---|---|---|---|---|
| TF1 and TS1 schematic values | TBD / BLOCKED | Rev A.4.1 placeholders are TF1 75 °C / 15 A and TS1 normally closed 75 °C / 16 A. The 75 °C values are not finalized production selections. | Current Rev A.4.1 schematic and standalone thermal results | High confidence that placeholders are not validated | Select temperatures only after installed-system thermal and fault mapping. | BOM freeze + Firmware constants + Fabrication |
| Thermal-device families | ASSUMPTION / PROVISIONAL | SCHOTT SEFUSE SF and Protherm 03EC are families to investigate, not selected parts and not BOM-final. | Phase-1 component-family review | Low-medium | Establish exact construction, package, current/voltage rating, trip tolerance, mounting method, aging, availability, and approvals. | PCB layout + BOM freeze + Fabrication |
| Protection ordering | DESIGN DECISION | `normal operating ceiling < firmware hard trip < independent hardware cutoff < lowest applicable material/component limit` with justified margins. | JumpJet safety architecture | High | Establish every numeric boundary from installed measurements and component/material limits. | BOM freeze + Firmware constants + Fabrication |
| Installed thermal evidence | TBD / BLOCKED | Required measurements include TF1 body, TS1 body, heater hotspot, chamber, enclosure/material, wiring, and connector temperatures under normal, failed-fan, restricted-airflow, and heater-stuck-on cases. | Standalone characterization explicitly does not cover installed behavior | High confidence that evidence is missing | Complete production-intent installed thermal mapping and fault testing. | BOM freeze + Firmware constants + Fabrication |

The approximately 130 °C heater/PTC and 74–75 °C chassis measurements do not
identify a valid production cutoff temperature or mounting location.

## 10. PCB implementation

| Item | Status | Current value / decision | Evidence / source | Confidence | Remaining validation | Blocks |
|---|---|---|---|---|---|---|
| Preferred enclosure-space reference | MEASURED | `Void directly from Prusa file.step` is the preferred current enclosure-space reference. Its AP242 solid is expressed in metres and behaves as a constant X-Z section extruded 268.000 mm along neutral-CAD Y. Parsed gross coordinate extents are approximately X = 192.950 mm, Y = 268.000 mm, and Z = 185.311 mm. These gross extents establish substantially more installation volume; they are not usable PCB dimensions and do not encode the local Jetpack placement. | `Void directly from Prusa file.step`, Onshape export dated 2026-09-04, SHA-256 `641c9b8e20736b3045403c1793836d2242f225e9beb8f6a878e22a60466472cd`; direct STEP entity, unit, and coordinate analysis | High for source geometry, units, and gross extents | Recover the rigid transform between this void and the installed Jetpack mount, then correlate printer directions, walls, service opening, and adjacent hardware. | Heater placement + PCB envelope + mounting + Edge.Cuts + Fabrication |
| Superseded small-void packing study | MEASURED | `Part Studio 1 - Internal Space.step` contains one closed 62.628 × 268.000 × 72.450 mm void with an approximately 2,728.653 mm² constant section and 0.731 L volume. The earlier result that a 41 × 41 × 105 mm conservative heater box does not fit its principal-axis section remains valid for that file, but the file is now known to be a smaller/incomplete local void. The result is retained as historical evidence and is no longer a system-level incompatibility or fabrication blocker. | `Part Studio 1 - Internal Space.step`, Onshape export dated 2026-09-04, SHA-256 `608b08534cdaa03be100230e1626da68c53977416f97d7f18e626874d7fa79fc`; direct STEP analysis; superseded by the preferred Prusa-derived void | High for the historical geometry and packing result | Use the preferred Prusa-derived void for current system packaging; retain this result only for provenance unless the smaller region is later identified physically. | None |
| Jetpack fan-attachment geometry | MEASURED | `jetpack-fan-attachment.step` is one AP242 solid expressed in metres. In its local fan-face datum it contains a four-hole pattern at X/Y = ±16.000 mm (32.000 × 32.000 mm spacing), nominal 3.500 mm holes, and concentric approximately 38.000 mm fan-aperture geometry. The exported solid's vertex bounds are approximately 46.850 × 51.698 × 48.000 mm. These dimensions identify local attachment geometry only; they do not establish printer orientation, airflow sign, or installed position. | `jetpack-fan-attachment.step`, Onshape export dated 2026-05-14, SHA-256 `16e8a43a846a8cf6bce9095980827f721db8490bd00f365e97459a208e2edd00`; direct STEP entity and coordinate analysis | High for the local pattern and neutral-CAD geometry | Correlate the fan face to the physical fan/heater stack and recover its installed transform to the preferred enclosure-space reference. | Heater placement + PCB plane + mounting + Edge.Cuts + Fabrication |
| Mechanical-source alignment | TBD / BLOCKED | No common rigid transform is preserved between the preferred Prusa-derived void and the separately exported Jetpack fan attachment. Their AP242 files each contain a single neutral-coordinate solid and no assembly occurrence relationship. The native `core_one_assembly.f3d` archive is readable as a Fusion container and the available AP214 assembly STEP contains printer assembly occurrences, but neither contains the separately exported `Fan attachment` product or an identified matching datum that locates it. Applying scale, translation, rotation, or reflection between these sources would therefore be invented. | Direct inspection of both AP242 structures; `core_one_assembly.f3d`, SHA-256 `2655b839e5e401ee191be4d3fdd8d40e6bd16377da94f2afcaf9258c17f5e113`; available AP214 assembly STEP, SHA-256 `4ead8073806c86df0e2309e905f84664715b2a09b9c384839aa33a8a8591aa08` | High confidence that the supplied exports do not close alignment | Provide one assembly/export containing both the Jetpack attachment and Prusa reference in preserved installed coordinates; alternatively provide three non-collinear corresponding datum points (or an origin plus two directed axes) measured/identified on both models. Also identify which fan-face normal points toward the cold-air side. | Heater placement + PCB plane/envelope + service/antenna directions + local constraint model + Edge.Cuts + Fabrication |
| Heater/fan occupied envelope | MEASURED | The current heater plus fan assembly occupies a 41 × 41 × 105 mm rectangular envelope inside the same available void. The production power supply remains outside the printer. | Direct assembly-envelope measurement supplied for the Phase-1 placement study | High for the supplied envelope; attachment datums are not encoded | Record the hot-air outlet datum, connector and wire exits, attachment features, and required operational/service clearances. | Heater placement + PCB envelope + mounting + Fabrication |
| Heater intake face | CONFIRMED FACT | The 41 × 41 mm face selected for possible PCB mounting is the heater/fan assembly's cold-air intake side. Incidental intake-air cooling must not be a safety dependency. | Physical assembly identification supplied for the Phase-1 placement study | High for face function | Record fan aperture and mounting-hole geometry, airflow direction in printer coordinates, connector/wire exits, and required unobstructed inlet/service volumes. | Heater placement + PCB envelope + mounting + Fabrication |
| PCB-over-intake architecture | ASSUMPTION / PROVISIONAL | Leading architecture is heater/fan → cold-air intake face → independent support/standoffs or integrated carrier → controller PCB. The PCB may overhang the fan body if aligned local geometry and airflow testing support it; no standoff height, use of shared fan screws, board outline, or service envelope is frozen. Intake airflow must not be credited as safety-critical PCB cooling. | Phase-1 mechanical steering; favorable cold-side topology; preferred enclosure-space reference removes the former system-volume objection | Medium concept confidence; installed alignment remains absent | Recover the installed transform, then establish bracket load path, standoff stack, PCB/component heights, inlet flow area, connector mating/fuse-pull/USB zones, cable corridors, and side-panel removal path. | PCB envelope + mounting + Fabrication |
| Heater placement in preferred void | TBD / BLOCKED | The preferred void removes the prior evidence of a fundamental heater/enclosure incompatibility, but no exact placement or collision clearance is established. The conservative 41 × 41 × 105 mm heater/fan envelope is a sanity envelope, not an installed transform or a substitute for actual heater geometry. | Preferred void gross extents; supplied heater/fan envelope; lack of a common Jetpack-to-void datum | High confidence that system volume is no longer the blocker; high confidence that local placement remains unproved | Supply the installed transform/common datums and identify actual heater body, fan, protrusion, cable-exit, mounting-penetration, intake, and outlet geometry. | PCB plane/envelope + mounting + Edge.Cuts + Fabrication |
| PCB plane and local envelope | TBD / BLOCKED | No defensible PCB plane, maximum rectangle, overhang, standoff range, component-height limit, shell clearance, service edge, USB/fuse/connector access zone, antenna-open direction, or airflow no-go region can be derived from gross void bounds. The Jetpack fan-face pattern supplies a useful local datum but is not located within the printer void. | Mechanical-source alignment audit | High confidence that local mechanics remain open | Align the sources and build the local constraint map; then validate the leading carrier strategies and a 1:1 physical mockup before freezing mechanics. | PCB envelope + Edge.Cuts + mounting + Fabrication |
| Production PSU location | DESIGN DECISION | Keep the production power supply outside the printer; only the protected incoming 24 V harness enters the Jump Jet installation volume. | Phase-1 system packaging direction | High | Define entry location, connector, strain relief, routing, and service access against the corrected/confirmed mechanical assembly. | PCB placement + harness + Fabrication |
| Rev A PCB state | CONFIRMED FACT | PCB design is the current Rev A implementation stage. A `.kicad_pcb` has not yet been created and must now be designed. | Rev A.4.1 package scope and Phase-1 project state | High | Create and review the first Rev A PCB from the authoritative schematic. | PCB layout + Fabrication |
| Authoritative KiCad source | CONFIRMED FACT | Rev A.4.1 native project source is checked in under [`hardware/kicad/JumpJet_RevA/`](../hardware/kicad/JumpJet_RevA/README.md): root schematic, four child sheets, project symbol/footprint libraries, library tables, minimal project file, preliminary BOM, and archive provenance README. Native KiCad 10.0.6 opens the root hierarchy and native ERC runs from that root. | `JumpJet_Controller_RevA4_1_J3_JST_XH.zip` intake, checked-in source, native KiCad 10.0.6 open, and `kicad-cli sch erc` | High | Preserve root-driven ERC validation as the schematic evolves. | PCB layout + Fabrication |
| KiCad source schema/validation | CONFIRMED FACT | Tooling blocker CLOSED: despite mixed source schema/generator provenance, KiCad 10.0.6 opens `JumpJet_Controller_RevA4.kicad_sch` with all four child sheets and native root-driven ERC is reusable with the installed standard library tables. Structural/off-grid and label-scope findings are cleared; remaining findings are explicit product blockers, intentional NC/TBD items, or individually reviewed cached-library differences. | Native KiCad 10.0.6 project open and root-driven ERC after structural cleanup | High | Re-run native ERC after each schematic change; do not hide unresolved product blockers. | PCB layout + Fabrication |
| Unresolved footprint references | TBD / BLOCKED | Rev A.4.1 intentionally contains unresolved placeholders `TBD:High_Current_2Pin`, `TBD:DC_DC_Module`, `TBD:Aux_2Pin`, and `Package_DirectFET:TBD`. Native ERC resolves installed standard and project-local non-placeholder libraries; only these deliberate footprint placeholders remain unresolved. | Native KiCad 10.0.6 root-driven ERC and checked-in schematic footprint properties | High | Replace every placeholder only after the corresponding part and footprint are verified. | PCB layout + BOM freeze + Fabrication |
| Preliminary archive BOM | CONFIRMED FACT | `BOM_PRELIMINARY.csv` is checked in as source context only. Its placeholders and historical values do not override this register and are not BOM-final. | [Rev A.4.1 preliminary BOM](../hardware/kicad/JumpJet_RevA/BOM_PRELIMINARY.csv) | High | Reconcile every line against reviewed schematic candidates and replace with a controlled production BOM later. | BOM freeze + Fabrication |
| J1/F1/MOD1 implementation | TBD / BLOCKED | `J1` remains `24V IN / 20A MIN` with placeholder footprint `TBD:High_Current_2Pin`; `F1` remains `15A TBD` with no footprint. `MOD1` now records LMR36520 as the strong-candidate buck architecture and outputs only `+5V_SYS_GATE`, but its connector symbol and `TBD:DC_DC_Module` footprint are explicitly placeholders rather than a discrete implementation. | [Checked-in Phase-1 power/output sheet](../hardware/kicad/JumpJet_RevA/JumpJet_Power_Outputs.kicad_sch) and preliminary BOM | High | Select/qualify exact input connector and main protection; implement the complete LMR36520 candidate circuit and verified footprints; validate service/thermal behavior, transients, and PSU/fuse coordination. | PCB layout + BOM freeze + Fabrication |
| Starting stackup | ASSUMPTION / PROVISIONAL | Two layers, 1.6 mm FR-4, 2 oz copper. | Phase-1 routing/current-density starting point | Medium | Review high-current routing, grounding, RF, mechanical, thermal, cost, and PCBWay manufacturing requirements before freeze. | PCB layout + BOM freeze + Fabrication |
| Heater-path copper geometry | ASSUMPTION / PROVISIONAL | Keep heater-path neckdowns at least 4 mm as an initial minimum; prefer broad 8–10 mm or wider pours where practical; minimize vias and unnecessary current-loop area. Place the high-current/safety path before convenience circuitry. | 8.33 A conservative design basis and Phase-1 layout direction | Medium | Calculate and inspect every bottleneck, layer transition, pad entry, thermal relief, and temperature rise for the final stackup. | PCB layout + Fabrication |
| Ground and return strategy | DESIGN DECISION | Prefer a continuous ground plane with a controlled heater/fan/buck high-current return corridor. Thermistor/ADC returns must not share narrow or common-impedance copper with heater current. Do not create arbitrary split grounds that damage ESP32 RF return integrity. | Phase-1 signal-integrity and current-return strategy | High for topology; implementation provisional | Review actual return geometry, buck loops, ADC noise, RF keepout, and current-path coupling after placement/routing. | PCB layout + Fabrication |
| High-current placement priority | DESIGN DECISION | Place and review `+24V_PROT -> F2 -> TF1 -> TS1 -> J2 -> heater -> Q1 -> GND` before convenience circuitry. Keep Q1, J2, F2, and the heater-current path compact without weakening conductor geometry for appearance. | Rev A.4.1 topology and Phase-1 implementation priority | High | Complete placement, current-loop, service-clearance, and thermal review. | PCB layout + Fabrication |
| PCB validation | TBD / BLOCKED | Current-density bottlenecks, Q1 thermal spreading, fuse-holder and J2 pad heating, high-current return geometry, ADC noise, antenna keepout, DRC, fabricated-board temperature rise, and full-path voltage drop are unvalidated. | No Rev A PCB exists yet | High confidence that validation is pending | Create the board, review design evidence, fabricate only after blockers close, then thermally/electrically test production-intent hardware. | PCB layout + BOM freeze + Fabrication |

## Current fabrication blockers

Fabrication remains blocked until all of the following are closed or deliberately
bounded by reviewed production-intent provisions:

- recover the installed rigid transform between the preferred Prusa-derived void and the Jetpack fan-attachment datum; the supplied neutral STEP exports do not preserve one
- map the aligned geometry to printer rear/left/up and the removable side/service-panel direction
- establish the heater inlet, outlet, wiring, attachment, removal, fan-face-normal, and clearance datums before selecting a PCB placement zone
- derive the local PCB plane, practical rectangular envelope, mounting strategy, airflow no-go area, service zones, and antenna-open direction; do not use gross void dimensions as board dimensions
- ESP32 provisional receiving-land depth/process geometry and 1:1 body/pad registration
- complete pin numbering/label verification beyond the physically identified Pin 1
- underside exposed-contact mapping and carrier isolation review
- antenna identity and conservative pre-fabrication keepout; installed RSSI/range qualification is post-prototype and pre-release
- USB connector, plug, cable-head, and service-access envelope
- optional locating holes must be physically fit-verified or deliberately omitted before footprint freeze
- select, rate, footprint, label, and mechanically validate D4 reverse isolation and the physical SW1 board-MCU-5-V service disconnect
- bench-validate the defined normal, USB-service, mixed-presence, removal, and misuse power-state matrix with the disconnect in its permitted positions
- bench validation of the implemented hardware-default-OFF gate-driver correction across the complete power-transition matrix
- complete regulator implementation, load measurement, and installed-temperature thermal analysis
- Q1 multipad/footprint and F2 holder-footprint verification
- four-wire fan connector/interface footprint and candidate electrical verification; schematic provisions pass structural native ERC checks but remain electrically unqualified
- TF1/TS1 part, mounting, and thermal-coupling implementation
- J1/F1 selections and footprints; MOD1 discrete-regulator implementation and footprint
- PCB envelope, mounting-hole coordinates, connector-facing edges, and USB datum
- final 1:1 production-footprint fit check with the actual module

## Register maintenance rules

- Preserve the exact status classes defined in this document.
- Change a status only when the evidence/source and remaining-validation fields
  are updated at the same time.
- A `STRONG CANDIDATE` or `PROTOTYPE CANDIDATE` does not become BOM-final by
  appearing here.
- Record contradictions and failed validation directly; do not silently replace
  inconvenient evidence.
- Link measurement reports, schematic revisions, datasheets, test records, and
  relevant commits wherever practical.
- Keep firmware GPIOs, ADC constants, PWM/RPM thresholds, thermal thresholds,
  and recovery limits provisional until the corresponding hardware evidence is
  complete.
