danielbrownjr/JumpJet/hardware/kicad/JumpJet_RevA/JumpJet_Controller.kicad_sch

## KiCad design hardware/kicad/JumpJet_RevA/JumpJet_Controller.kicad_sch (2026-09-09)

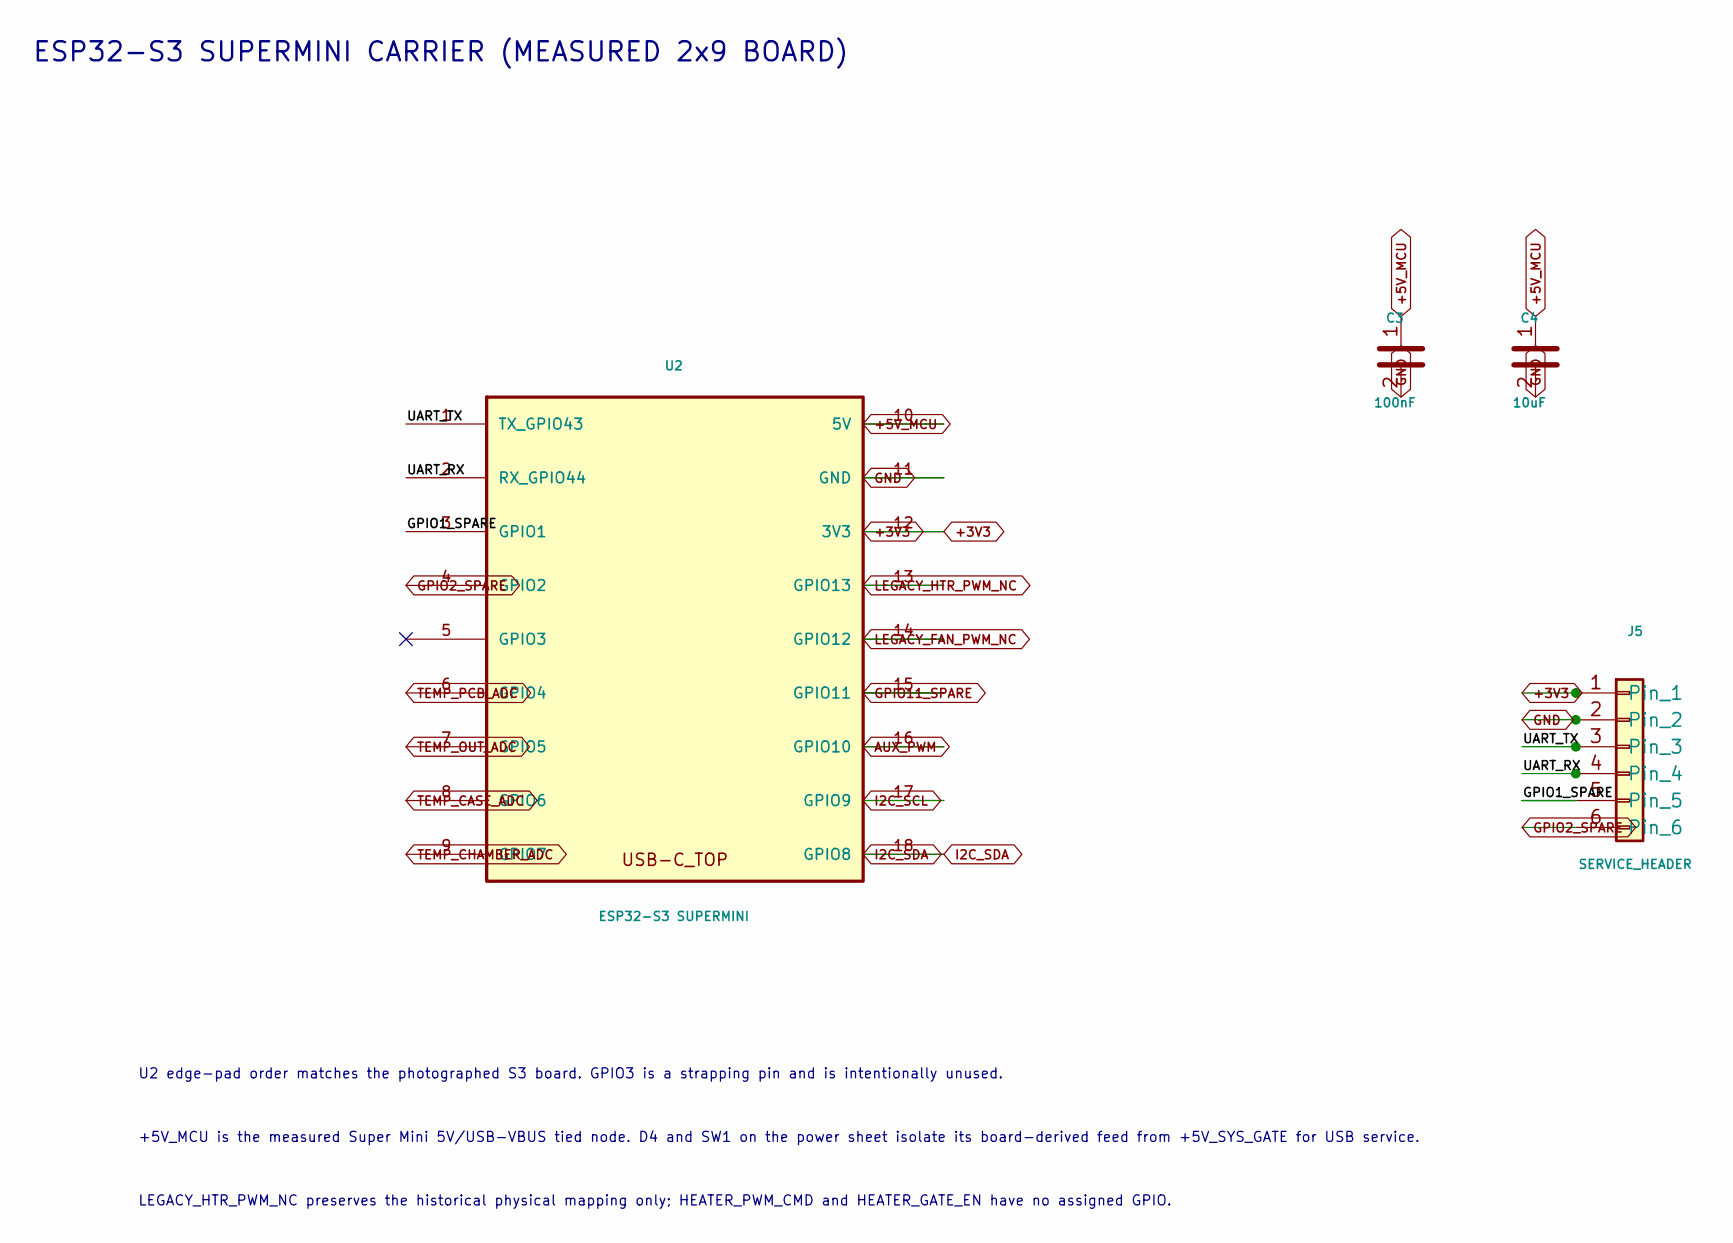
[picture p1: schematic JumpJet_Controller.kicad_sch]

Parts:
C3: 100nF; C_0603_1608Metric
C4: 10uF; C_0805_2012Metric
J5: SERVICE_HEADER; PinHeader_1x06_P2.54mm_Vertical
U2: ESP32-S3 SUPERMINI; ESP32-S3_SuperMini_2x9

Connections:
+3V3: J5.1, U2.12 (3V3)
+5V_MCU: C3.1, C4.1, U2.10 (5V)
AUX_PWM: U2.16 (GPIO10)
GND: C3.2, C4.2, J5.2, U2.11 (GND)
GPIO1_SPARE: J5.5, U2.3 (GPIO1)
GPIO2_SPARE: J5.6, U2.4 (GPIO2)
GPIO11_SPARE: U2.15 (GPIO11)
I2C_SCL: U2.17 (GPIO9)
I2C_SDA: U2.18 (GPIO8)
LEGACY_FAN_PWM_NC: U2.14 (GPIO12)
LEGACY_HTR_PWM_NC: U2.13 (GPIO13)
TEMP_CASE_ADC: U2.8 (GPIO6)
TEMP_CHAMBER_ADC: U2.9 (GPIO7)
TEMP_OUT_ADC: U2.7 (GPIO5)
TEMP_PCB_ADC: U2.6 (GPIO4)
UART_RX: J5.4, U2.2 (RX_GPIO44)
UART_TX: J5.3, U2.1 (TX_GPIO43)

Notes on the sheet:
ESP32-S3 SUPERMINI CARRIER (MEASURED 2x9 BOARD)
U2 edge-pad order matches the photographed S3 board. GPIO3 is a strapping pin and is intentionally unused.
+5V_MCU is the measured Super Mini 5V/USB-VBUS tied node. D4 and SW1 on the power sheet isolate its board-derived feed from +5V_SYS_GATE for USB service.
LEGACY_HTR_PWM_NC preserves the historical physical mapping only; HEATER_PWM_CMD and HEATER_GATE_EN have no assigned GPIO.
