danielbrownjr/JumpJet/hardware/kicad/JumpJet_RevA/JumpJet_Expansion_Test.kicad_sch

## KiCad design hardware/kicad/JumpJet_RevA/JumpJet_Expansion_Test.kicad_sch (2026-09-07)

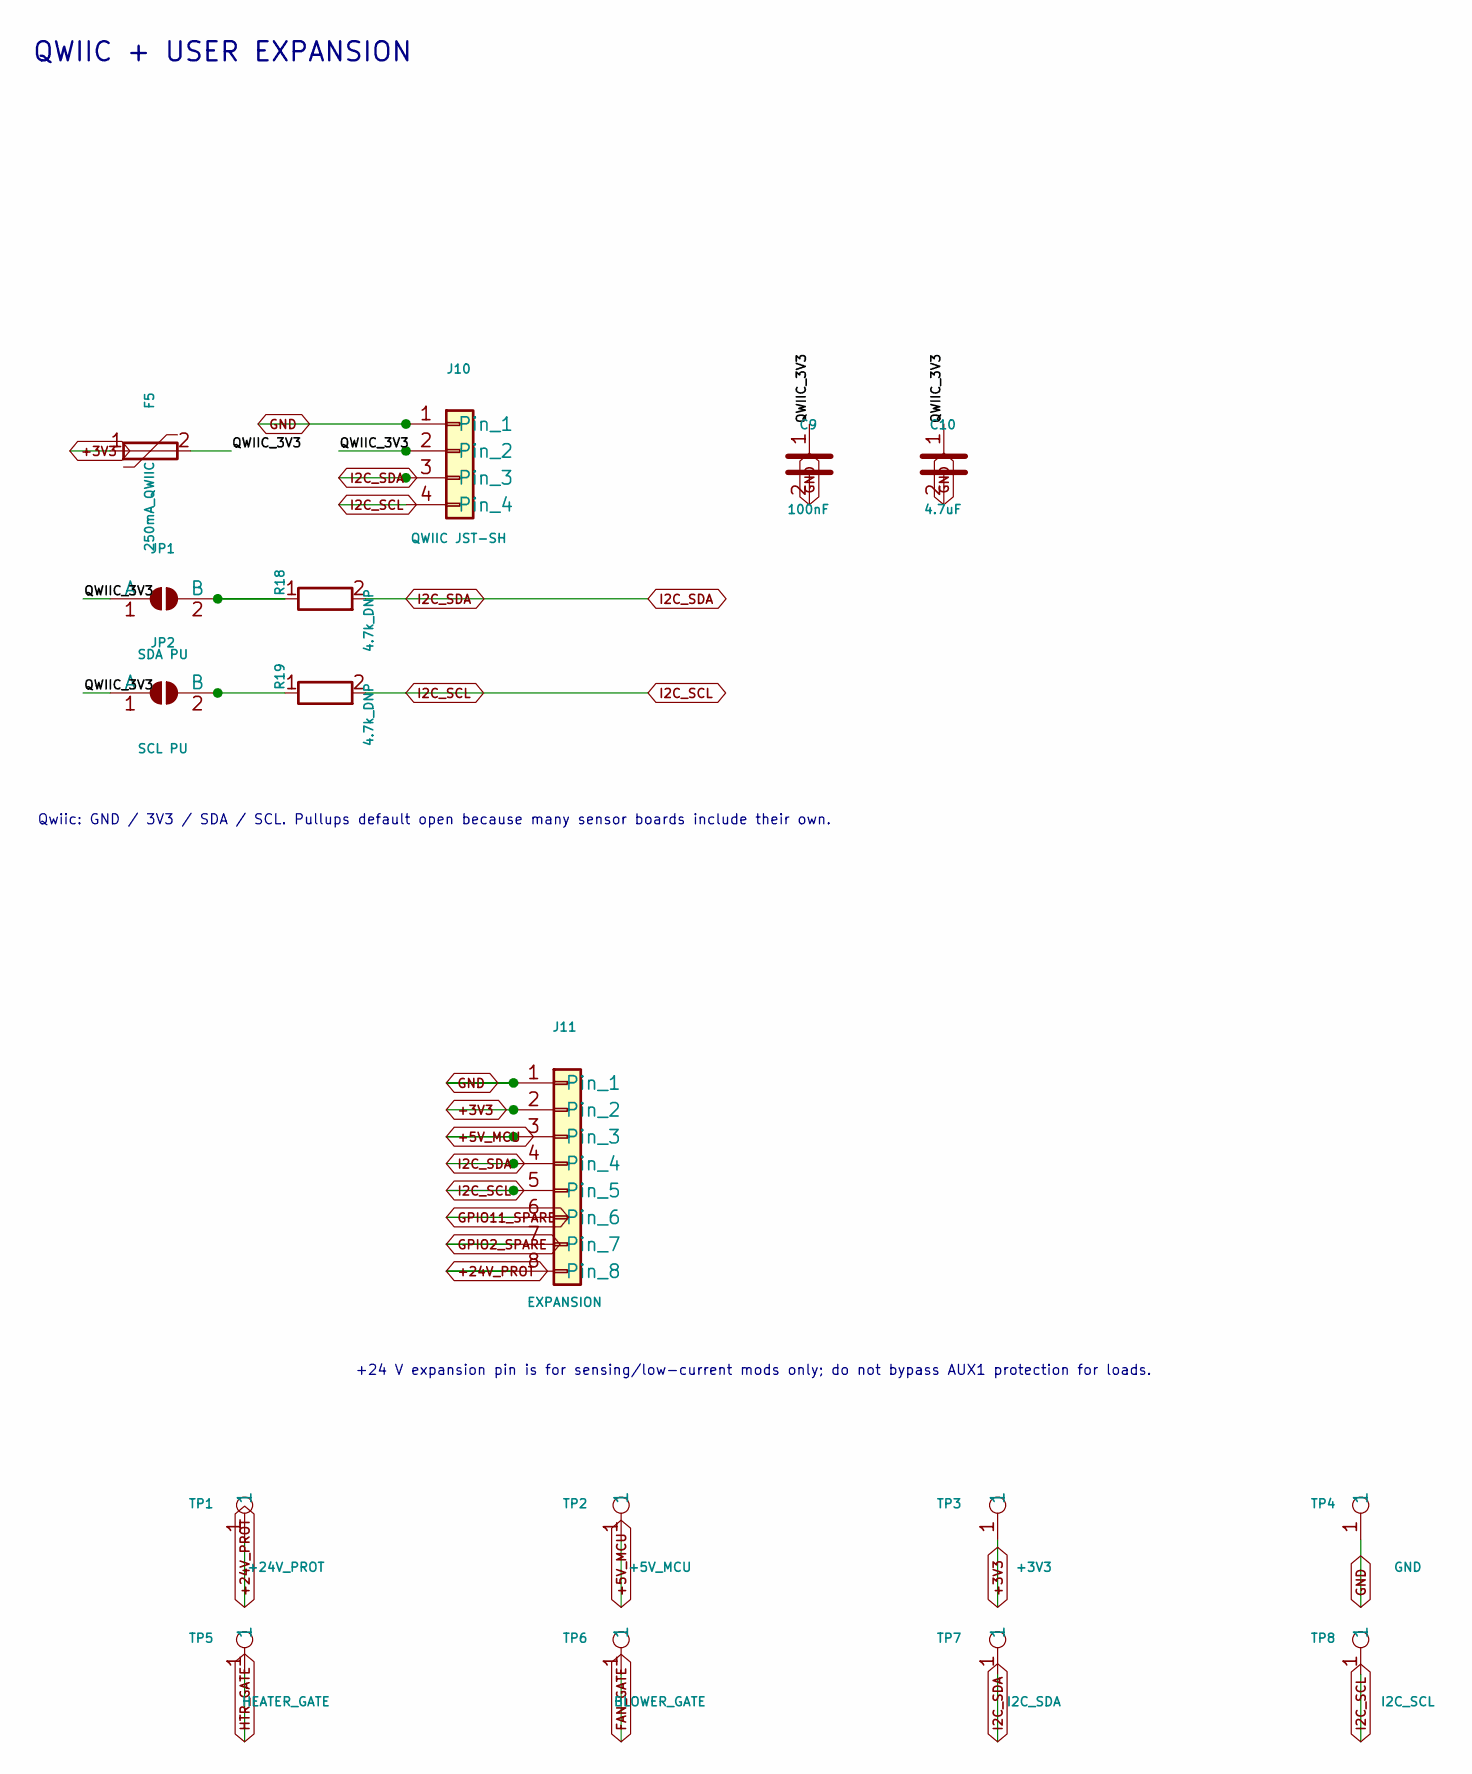
[picture p2: schematic JumpJet_Expansion_Test.kicad_sch]

Parts:
C9: 100nF; C_0603_1608Metric
C10: 4.7uF; C_0805_2012Metric
F5: 250mA_QWIIC; Fuse_1206_3216Metric
J10: QWIIC JST-SH; JST_SH_SM04B-SRSS-TB_1x04-1MP_P1.00mm_Horizontal
J11: EXPANSION; PinHeader_1x08_P2.54mm_Vertical
JP1: SDA PU; SolderJumper-2_P1.3mm_Open_Pad1.0x1.5mm
JP2: SCL PU; SolderJumper-2_P1.3mm_Open_Pad1.0x1.5mm
R18, R19: 4.7k_DNP; R_0603_1608Metric
TP1: +24V_PROT; TestPoint_Pad_D1.5mm
TP2: +5V_MCU; TestPoint_Pad_D1.5mm
TP3: +3V3; TestPoint_Pad_D1.5mm
TP4: GND; TestPoint_Pad_D1.5mm
TP5: HEATER_GATE; TestPoint_Pad_D1.5mm
TP6: BLOWER_GATE; TestPoint_Pad_D1.5mm
TP7: I2C_SDA; TestPoint_Pad_D1.5mm
TP8: I2C_SCL; TestPoint_Pad_D1.5mm

Connections:
+3V3: F5.1, J11.2, TP3.1
+5V_MCU: J11.3, TP2.1
+24V_PROT: J11.8, TP1.1
FAN_GATE: TP6.1
GND: C9.2, C10.2, J10.1, J11.1, TP4.1
GPIO2_SPARE: J11.7
GPIO11_SPARE: J11.6
HTR_GATE: TP5.1
I2C_SCL: J10.4, J11.5, R19.2, TP8.1
I2C_SDA: J10.3, J11.4, R18.2, TP7.1
unnamed: JP1.2 (B), R18.1
unnamed: JP2.2 (B), R19.1
QWIIC_3V3: C9.1, C10.1, F5.2, J10.2, JP1.1 (A), JP2.1 (A)

Notes on the sheet:
+24 V expansion pin is for sensing/low-current mods only; do not bypass AUX1 protection for loads.
Qwiic: GND / 3V3 / SDA / SCL. Pullups default open because many sensor boards include their own.
QWIIC + USER EXPANSION
