danielbrownjr/JumpJet/hardware/kicad/JumpJet_RevA/JumpJet_Power_Outputs.kicad_sch

## KiCad design hardware/kicad/JumpJet_RevA/JumpJet_Power_Outputs.kicad_sch (2026-09-08)

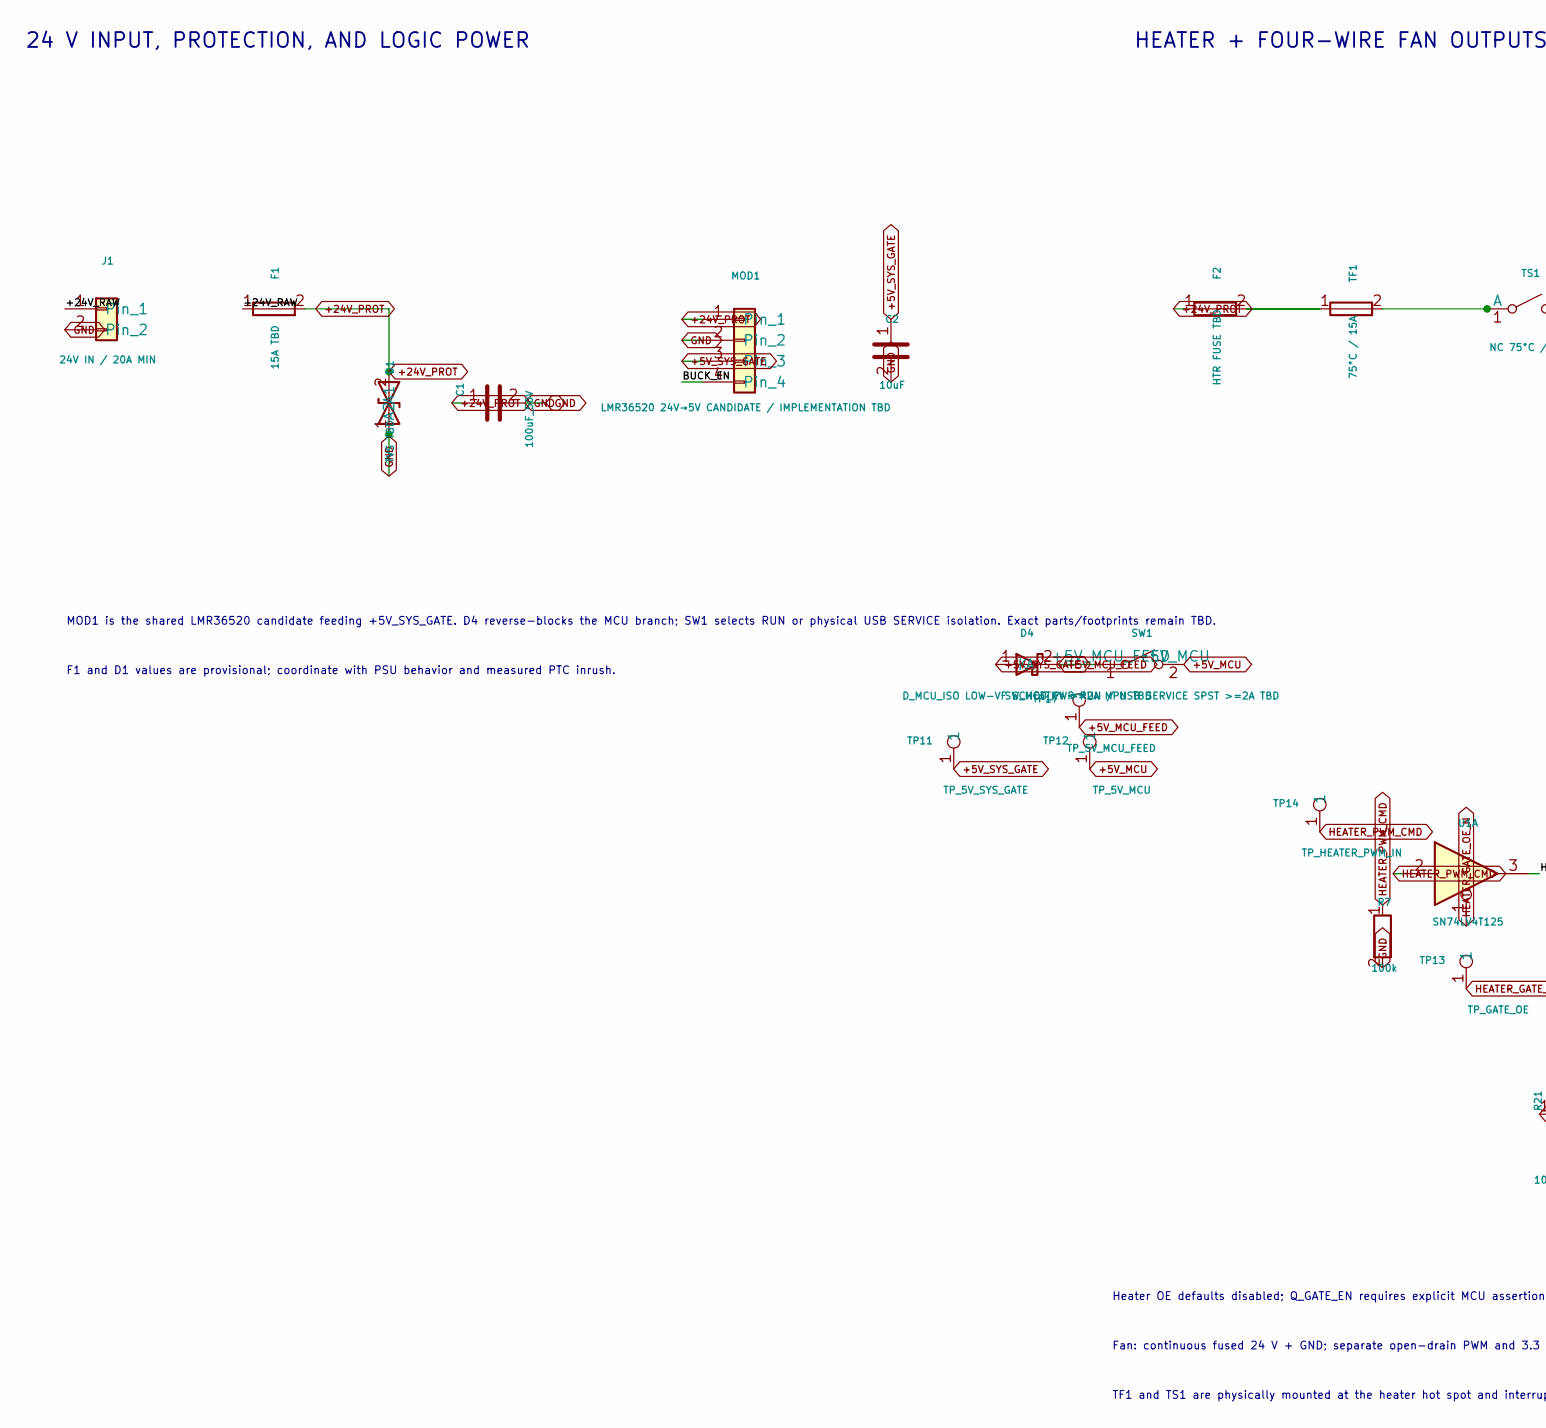
[picture p3: schematic JumpJet_Power_Outputs.kicad_sch, part in row 1, column 1]

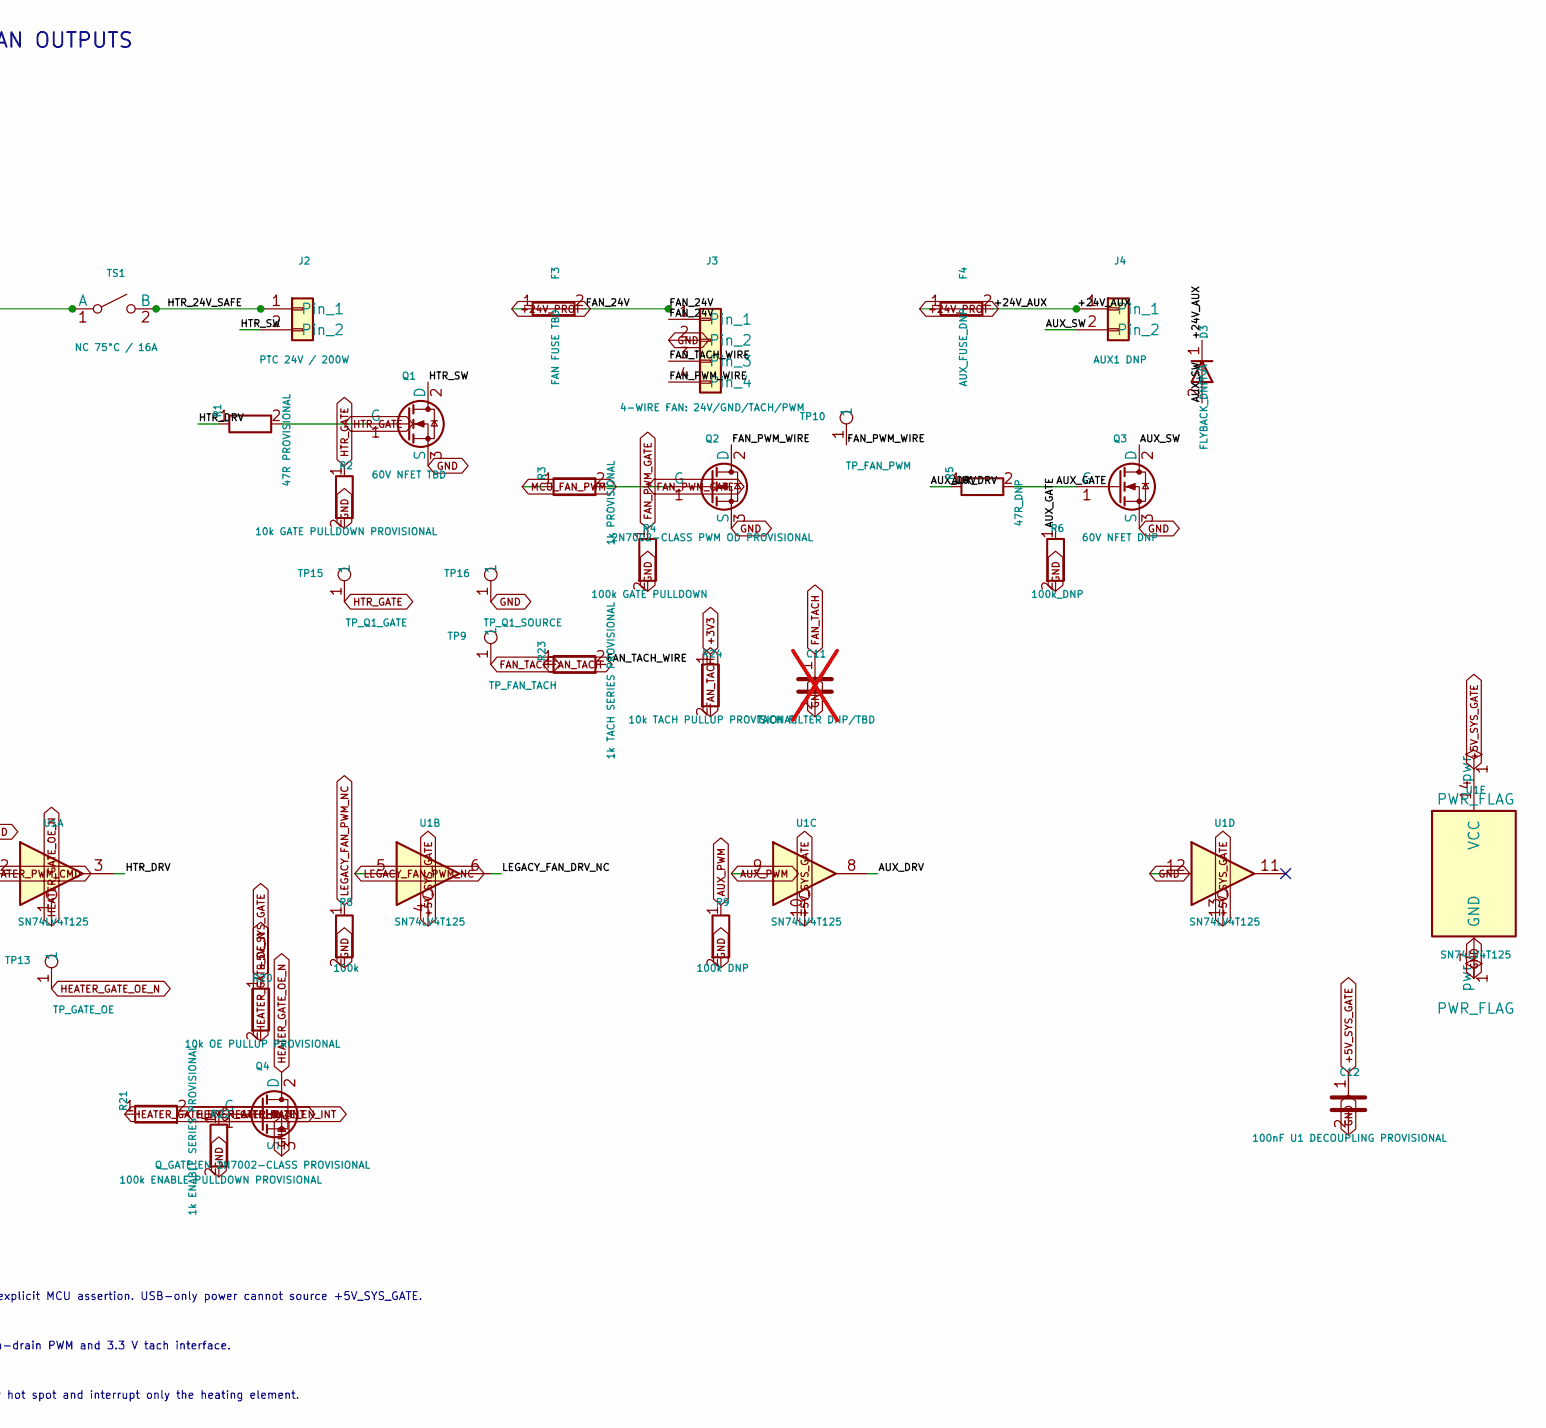
[picture p4: schematic JumpJet_Power_Outputs.kicad_sch, part in row 1, column 2]

Parts:
C1: 100uF_50V; CP_Radial_D10.0mm_P5.00mm
C2: 10uF; C_0805_2012Metric
C11: TACH FILTER DNP/TBD; C_0603_1608Metric; not fitted
C12: 100nF U1 DECOUPLING PROVISIONAL; C_0603_1608Metric
D1: TVS TBD; D_SMB
D3: FLYBACK_DNP; D_SMA
D4: D_MCU_ISO LOW-VF SCHOTTKY >=2A MPN TBD
F1: 15A TBD
F2: HTR FUSE TBD
F3: FAN FUSE TBD
F4: AUX_FUSE_DNP
J1: 24V IN / 20A MIN; High_Current_2Pin
J2: PTC 24V / 200W; TerminalBlock_Phoenix_MKDS-1,5-2_1x02_P5.00mm_Horizontal
J3: 4-WIRE FAN: 24V/GND/TACH/PWM; JST_XH_B4B-XH-A_1x04_P2.50mm_Vertical
J4: AUX1 DNP; Aux_2Pin
MOD1: LMR36520 24V→5V CANDIDATE / IMPLEMENTATION TBD; DC_DC_Module
Q1: 60V NFET TBD; TBD
Q2: 2N7002-CLASS PWM OD PROVISIONAL; SOT-23
Q3: 60V NFET DNP; TBD
Q4: Q_GATE_EN 2N7002-CLASS PROVISIONAL; SOT-23
R1: 47R PROVISIONAL
R2: 10k GATE PULLDOWN PROVISIONAL
R3: 1k PROVISIONAL
R4: 100k GATE PULLDOWN
R5: 47R_DNP
R6: 100k_DNP
R7, R8: 100k
R9: 100k DNP
R20: 10k OE PULLUP PROVISIONAL; R_0603_1608Metric
R21: 1k ENABLE SERIES PROVISIONAL; R_0603_1608Metric
R22: 100k ENABLE PULLDOWN PROVISIONAL; R_0603_1608Metric
R23: 1k TACH SERIES PROVISIONAL; R_0603_1608Metric
R24: 10k TACH PULLUP PROVISIONAL; R_0603_1608Metric
SW1: SW_MCU_PWR RUN / USB SERVICE SPST >=2A TBD
TF1: 75°C / 15A
TP9: TP_FAN_TACH; TestPoint_Pad_D1.5mm
TP10: TP_FAN_PWM; TestPoint_Pad_D1.5mm
TP11: TP_5V_SYS_GATE; TestPoint_Pad_D1.5mm
TP12: TP_5V_MCU; TestPoint_Pad_D1.5mm
TP13: TP_GATE_OE; TestPoint_Pad_D1.5mm
TP14: TP_HEATER_PWM_IN; TestPoint_Pad_D1.5mm
TP15: TP_Q1_GATE; TestPoint_Pad_D1.5mm
TP16: TP_Q1_SOURCE; TestPoint_Pad_D1.5mm
TP17: TP_5V_MCU_FEED; TestPoint_Pad_D1.5mm
TS1: NC 75°C / 16A
U1: SN74LV4T125; TSSOP-14_4.4x5mm_P0.65mm

Connections:
+3V3: R24.1
+5V_MCU: SW1.2 (+5V_MCU), TP12.1
+5V_MCU_FEED: D4.2 (K), SW1.1 (+5V_MCU_FEED), TP17.1
+5V_SYS_GATE: C2.1, C12.1, D4.1 (A), MOD1.3, R20.1, TP11.1, U1.4, U1.10, U1.13, U1.14 (VCC)
+24V_AUX: D3.1 (K), F4.2, J4.1
+24V_PROT: C1.1, D1.2 (A2), F1.2, F2.1, F3.1, F4.1, MOD1.1
+24V_RAW: F1.1, J1.1
AUX_DRV: R5.1, U1.8
AUX_GATE: Q3.1 (G), R5.2, R6.1
AUX_PWM: R9.1, U1.9
AUX_SW: D3.2 (A), J4.2, Q3.2 (D)
BUCK_EN: MOD1.4
FAN_24V: F3.2, J3.1
FAN_PWM_GATE: Q2.1 (G), R3.2, R4.1
FAN_PWM_WIRE: J3.4, Q2.2 (D), TP10.1
FAN_TACH: C11.1, R23.1, R24.2, TP9.1
FAN_TACH_WIRE: J3.3, R23.2
GND: C1.2, C2.2, C11.2, C12.2, D1.1 (A1), J1.2, J3.2, MOD1.2, Q1.3 (S), Q2.3 (S), Q3.3 (S), Q4.3 (S), R2.2, R4.2, R6.2, R7.2, R8.2, R9.2, R22.2, TP16.1, U1.7 (GND), U1.12
HEATER_GATE_EN: R21.1
HEATER_GATE_EN_INT: Q4.1 (G), R21.2, R22.1
HEATER_GATE_OE_N: Q4.2 (D), R20.2, TP13.1, U1.1
HEATER_PWM_CMD: R7.1, TP14.1, U1.2
HTR_24V_SAFE: J2.1, TS1.2 (B)
HTR_DRV: R1.1, U1.3
HTR_GATE: Q1.1 (G), R1.2, R2.1, TP15.1
HTR_SW: J2.2, Q1.2 (D)
LEGACY_FAN_DRV_NC: U1.6
LEGACY_FAN_PWM_NC: R8.1, U1.5
MCU_FAN_PWM: R3.1
unnamed: F2.2, TF1.1
unnamed: TF1.2, TS1.1 (A)

Notes on the sheet:
24 V INPUT, PROTECTION, AND LOGIC POWER
MOD1 is the shared LMR36520 candidate feeding +5V_SYS_GATE. D4 reverse-blocks the MCU branch; SW1 selects RUN or physical USB SERVICE isolation. Exact parts/footprints remain TBD.
Heater OE defaults disabled; Q_GATE_EN requires explicit MCU assertion. USB-only power cannot source +5V_SYS_GATE.
F1 and D1 values are provisional; coordinate with PSU behavior and measured PTC inrush.
HEATER + FOUR-WIRE FAN OUTPUTS
Fan: continuous fused 24 V + GND; separate open-drain PWM and 3.3 V tach interface.
TF1 and TS1 are physically mounted at the heater hot spot and interrupt only the heating element.
