danielbrownjr/JumpJet/hardware/kicad/JumpJet_RevA/JumpJet_Temperature_Sensing.kicad_sch

## KiCad design hardware/kicad/JumpJet_RevA/JumpJet_Temperature_Sensing.kicad_sch (2026-09-09)

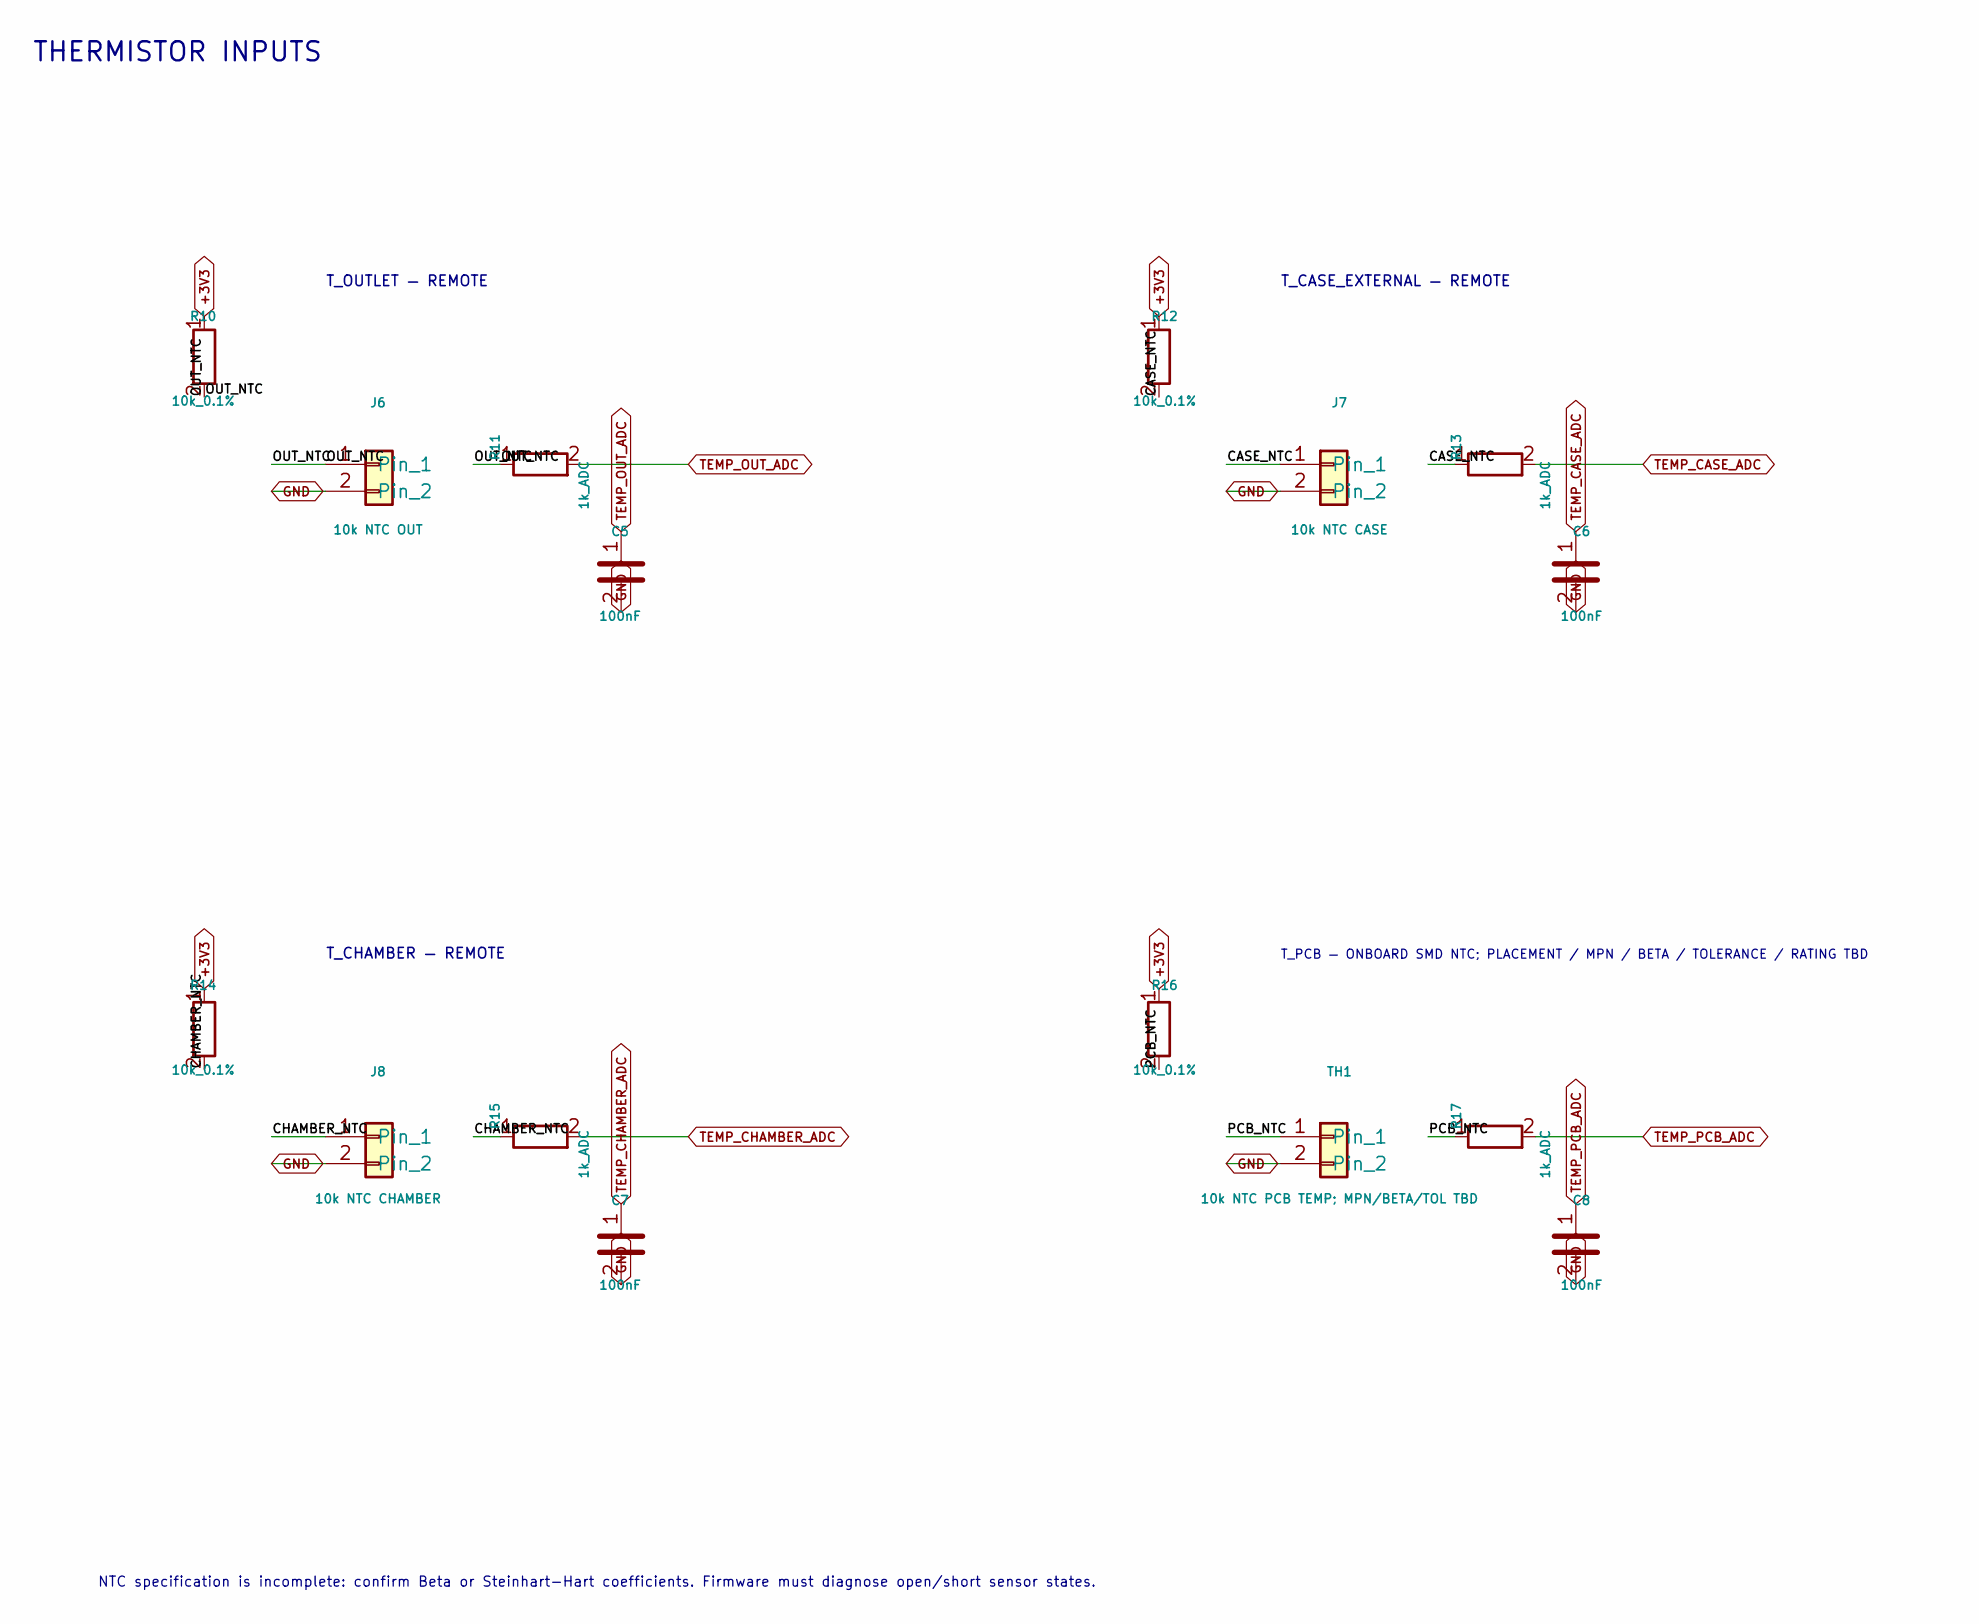
[picture p5: schematic JumpJet_Temperature_Sensing.kicad_sch]

Parts:
C5, C6, C7, C8: 100nF; C_0603_1608Metric
J6: 10k NTC OUT; JST_XH_B2B-XH-A_1x02_P2.50mm_Vertical
J7: 10k NTC CASE; JST_XH_B2B-XH-A_1x02_P2.50mm_Vertical
J8: 10k NTC CHAMBER; JST_XH_B2B-XH-A_1x02_P2.50mm_Vertical
R10, R12, R14, R16: 10k_0.1%; R_0603_1608Metric
R11, R13, R15, R17: 1k_ADC; R_0603_1608Metric
TH1: 10k NTC PCB TEMP; MPN/BETA/TOL TBD; R_0603_1608Metric

Connections:
+3V3: R10.1, R12.1, R14.1, R16.1
CASE_NTC: J7.1, R12.2, R13.1
CHAMBER_NTC: J8.1, R14.2, R15.1
GND: C5.2, C6.2, C7.2, C8.2, J6.2, J7.2, J8.2, TH1.2
OUT_NTC: J6.1, R10.2, R11.1
PCB_NTC: R16.2, R17.1, TH1.1
TEMP_CASE_ADC: C6.1, R13.2
TEMP_CHAMBER_ADC: C7.1, R15.2
TEMP_OUT_ADC: C5.1, R11.2
TEMP_PCB_ADC: C8.1, R17.2

Notes on the sheet:
THERMISTOR INPUTS
NTC specification is incomplete: confirm Beta or Steinhart-Hart coefficients. Firmware must diagnose open/short sensor states.
T_OUTLET — REMOTE
T_CASE_EXTERNAL — REMOTE
T_CHAMBER — REMOTE
T_PCB — ONBOARD SMD NTC; PLACEMENT / MPN / BETA / TOLERANCE / RATING TBD
