danielbrownjr/JumpJet/(commit log)

2026-08-24 feat: establish cold-safe Jump Jet dragon-core foundation
    [partitions.csv]
2026-08-25 docs: add Klipper integration TODO
2026-08-29 fix(interlock): fail cold on invalid safety inputs
    [jj_interlock_host_test.c]
2026-08-29 docs: isolate legacy firmware and track safety evidence
2026-08-29 fix(interlock): reject weaker policy overrides
    [jj_interlock_host_test.c]
2026-08-29 fix(interlock): strengthen cold-safe input policy
    [jj_interlock_host_test.c]
2026-09-02 docs: add CZ4060 heater characterization
2026-09-04 docs: update ESP32 physical hardware facts
2026-09-04 chore: add authoritative Rev A KiCad source
    [BOM_PRELIMINARY.csv, JumpJet_Controller.kicad_sch, JumpJet_Controller_RevA4.kicad_sch, JumpJet_Expansion_Test.kicad_sch, JumpJet_Power_Outputs.kicad_sch, JumpJet_Temperature_Sensing.kicad_sch]
2026-09-04 hardware: add provisional ESP32 castellated footprint
2026-09-04 docs: record heater void packing blocker
2026-09-06 hardware: replace fan block with four-wire interface
    [BOM_PRELIMINARY.csv, JumpJet_Controller.kicad_sch, JumpJet_Power_Outputs.kicad_sch]
2026-09-06 docs: refresh Phase 1 fan and hardware contract
2026-09-07 hardware: separate gate power and default-disable heater driver
    [BOM_PRELIMINARY.csv, JumpJet_Controller.kicad_sch, JumpJet_Expansion_Test.kicad_sch, JumpJet_Power_Outputs.kicad_sch]
2026-09-07 docs: record Phase 1 power-domain safety architecture
2026-09-07 docs: complete regulator candidate evidence
2026-09-08 hardware: require physical MCU service disconnect
    [BOM_PRELIMINARY.csv, JumpJet_Controller.kicad_sch, JumpJet_Power_Outputs.kicad_sch]
2026-09-08 hardware: connect Rev A fan header
    [JumpJet_Power_Outputs.kicad_sch]
2026-09-08 hardware: clean structural ERC findings
    [JumpJet_Power_Outputs.kicad_sch]
2026-09-08 hardware: implement MCU power isolation and service disconnect
    [BOM_PRELIMINARY.csv, JumpJet_Controller.kicad_sch, JumpJet_Power_Outputs.kicad_sch]
2026-09-09 hardware: add onboard PCB thermistor channel
    [BOM_PRELIMINARY.csv, JumpJet_Controller.kicad_sch, JumpJet_Temperature_Sensing.kicad_sch]
2026-09-15 docs: characterize TinyS3D candidate module
    Confirm 8 MB flash and through-hole mounting from specimen evidence.
    Record the actual JumpJet Phase 0 firmware build and boot, replacing CircuitPython.
    Keep 5 V / USB VBUS behavior unresolved and capture remaining characterization work.
    Consolidate candidate status in the hardware register and retain durable bench details.
2026-09-15 docs: record TinyS3D reverse-voltage observation
